daniilpass/edog/cad/custom/README.md

# STL для печати

Что печатать для текущей версии (на XIAO) и в каком количестве, сказано в [README](../../README.md#что-напечатать). Здесь описано, что представляет собой каждая деталь и как её печатать.

Оригиналы лежат в `cad/origin/` и не редактируются. Исправленный оригинальный блок привода — `cad/origin/geometry_fix/fixed_motor_bloc.stl`.
Тестовые вставки для проверки посадок — в `tests/`.

| Файл | Что это | Исходник |
|---|---|---|
| `chassis_large.stl` | большой корпус со стрелкой «перёд» на полу | `cad/freecad/EDOG_T_Front_Mark.FCStd` |
| `chassis_small.stl` | компактный корпус под площадку на магнитах (версия на RPi, для XIAO не нужен) | `cad/freecad/body_magnets.FCStd` |
| `platform_small.stl` | крышка корпуса на 4 магнитах 6×2, 113×70: в версии на XIAO на ней лежит батарея, в версии на RPi на ней стоит Raspberry Pi | `cad/freecad/body_magnets.FCStd` |
| `motor_block.stl`, `motor_block_insert.stl` | блок привода с гнездом серво 23.5 × 12.5 мм и вставка | `cad/freecad/EDOG_R_Servo_Fit.FCStd` |
| `tibia.stl`, `tibia_insert.stl` | голень с гнездом серво 23.5 × 12.5 мм и вставка. Для левых ног — как есть, для правых — зеркально (Mirror в слайсере) | `cad/freecad/Tibia_v2_SG90_fit.FCStd` |
| `femur_double_with_supports.stl` | бедро под двухсторонний лепесток, вал Ø7.1, с поддержками | `cad/freecad/Femur_hub71_double.FCStd` |
| `dc_deck.stl` | дека под UBEC 8A и DC-DC 2×USB (вариант на XIAO ESP32-S3) | `cad/freecad/EDOG_V_XIAO_Layout.FCStd` |
| `xiao_stand.stl` | подставка XIAO ESP32-S3 Sense: держит USB-C и объектив, 2 винта M3 в пол | `cad/freecad/EDOG_V_XIAO_Layout.FCStd` |
| `xiao_stand_with_supports.stl` | та же подставка XIAO с поддержками под мостом над окном штекера (стенки 0.8, зазор 0.2 сверху и снизу, 0.8 до ног) | `cad/freecad/EDOG_V_XIAO_Layout.FCStd` |
| `xiao_stand_cap.stl` | крышка подставки XIAO: над платами, язык на объектив, 2 самореза M1.7 | `cad/freecad/EDOG_V_XIAO_Layout.FCStd` |
| `pca_brackets.stl` | рамка PCA: 2 Г-полки 3 мм за платой (M3 с гайкой через нижние отверстия), 2 винта M3 в пол | `cad/freecad/EDOG_V_XIAO_Layout.FCStd` |
| `body_shell.stl` | гранёный кожух в габарите шасси (не выступает): стенка 0.8 (2 периметра), ~19.4 г, на крыше сквозная надпись EDOG (Arial Bold 20 мм, трафаретная перемычка 1.4 через все буквы, в D и O ещё вертикальная 1.4 — середины держатся в 4 точках и не проворачиваются; средняя палка E расширена симметрично, щели по 1.6) и по 4 поперечные прорези 3 мм с каждой стороны — «позвоночник», отступы до края крыши и до козырька по 3.8; стоит на стенках шасси (Z 18) и на платформе (Z 22), держится 4 магнитами 6×2 в стойках над угловыми магнитами платформы. Батарея на стяжках к платформе — кожух её не держит, рёбер нет. В середине борта юбка идёт по скосу моторной рамы на 1 мм ниже её края (заходит за раму изнутри, щели сбоку нет); у ножек платформы (углы с магнитами) юбки нет: край прямой, щель до видимой ножки ~1.2 мм со стороны торца и 2 мм со стороны центра (платформа может сдвинуться на магнитах на 1 мм и не упрётся). Спереди проём под XIAO, сверху на него клеится козырёк. Печать крышей вниз (STL уже повёрнут), без поддержек, 200×70 | `cad/freecad/EDOG_V_XIAO_Layout.FCStd` (`BodyShell`) |
| `xiao_visor.stl` | козырёк-«голова» над XIAO, ~3.6 г, ширина Y 15.5…54.4: клеится сверху на кожух — низ стенок повторяет поверхность кожуха вокруг проёма; передняя стенка над вырезом подставки доходит до торца шасси. Окно камеры по прямоугольному вырезу подставки (+0.5). На крыше два продольных паза 3 мм под вывод плоской антенны: вдоль боковых краёв крыши над боками крышки подставки (антенна выходит сбоку крышки): Y 22.9 и 47.0, X 134–161, концы скруглены, до кромки крыши ~2.7. До XIAO 0.58, до крышки подставки 0.78. Печать крышей вниз, без поддержек | `cad/freecad/EDOG_V_XIAO_Layout.FCStd` (`XiaoVisor`) |
| `gamepad_phone_holder_fold6.stl` | держатель телефона на Xbox-геймпад под сложенный Galaxy Fold 6 в Kindsuit (~71.5×16): чашки S-пружины шире на 8 мм, натяг ~5 мм; скоба на геймпад без изменений. PLA без заполнения, боком на стол | [XBox Controller Phone Holder](https://www.thingiverse.com/thing:5762576) by spiderkitty72, CC BY |

## Электроника на XIAO ESP32-S3 Sense (EDOG_V)

Сборка `EDOG_V_XIAO_Layout.FCStd` — корпус `chassis_large` без изменений, крышка 113×70 (`OriginalSizePlatform`). Модель XIAO — официальный STEP Seeed (`cad/vendor/xiao_esp32s3_sense/`).

- **LiPo 2S 2200 (110×31×14)** — на крышке по центру, провода назад; спускаются в щель между PCA и крышкой.
- **PCA9685** — в задней открытой зоне, на ребре: клеммы вниз (провода клемм — 2–3 мм под платой), верх на ~1 мм выше стенки, компоненты и разъёмы серво вперёд; тыл платы в 7 мм от задней стенки. Рамка (`pca_brackets.stl`, ~0.9 г): две вертикальные полки 3 мм вплотную за платой у нижних отверстий; винт M3 спереди через отверстие платы и полку (Ø3.6), гайка — на задней стороне полки (до ножек платы 1.2 мм, до стенки корпуса 1.4 мм; винт M3×8). Полосы 1 мм по полу под платой ведут к дальним отверстиям пола (X −5.5 × Y 11.8 и 60.8) + перемычка. Верхние отверстия PCA заняты припоем. Сборка: рамка винтами в пол (до PCA — потом винты закрыты разъёмами) → плата к полкам → M3 с гайками.
- **Дека** (`dc_deck.stl`, ~6 г) — под крышкой, скелет: две рамки-посадки, сцепленные между собой, и рычаги к трём пятакам под винты M3 (X 26.9 × Y 11.8 и 60.8, X 104.9 × Y 11.8 — отверстия пола, не закрытые платами). Винт обычный, головка сверху; в печатных деталях отверстия Ø3.6 — свободный проход, в отверстия пола (Ø3) M3 вкручивается с усилием — гайка снизу по желанию. Стенки, рельсы, основание рамок, рычаги и пятаки под винты — 1 мм.
  - UBEC 8A — рамка 52.6×36.6 с бортами 4 мм, по торцам только углы: выход (3-пин) назад к PCA, вход вперёд. Основание 1 мм: половина со стороны выхода — сплошной пол, вторая половина — кольцо 5 мм; UBEC на двустороннем скотче.
  - DC-DC 2×USB (текстолит 57×18, USB свисает за край на ~11 мм — над торцом рамки) — рамка только для положения: бока до верха текстолита, торцы на 0.6 ниже (под свесом USB), пол залит, кроме 16 мм у каждого торца, внутри рельсы под кромки платы — ножки выводов до 3.4 мм под текстолитом. Зазор 0.5 мм, плата на двустороннем скотче на рельсах. Рамка симметричная: плата ставится USB назад (как в сборке) или вперёд. Клеммник DC — общая точка: туда идут и T-plug батареи, и вход UBEC.
- **T-plug** — без своего места, прижат проводами над платами.
- **Подставка XIAO** (`xiao_stand.stl`, ~8 г + `xiao_stand_cap.stl`, ~1.2 г) — в передней открытой зоне, планка — 2 винта M3 в пол (X 137.3 × Y 11.8 и 60.8, отверстия Ø3.6).
  - XIAO стоит **USB-C вниз**, подставка держит разъём USB-C и объектив.
  - Крышка ложится сверху над платами (зазор 0.8), язык прижимает объектив, крючок заходит за плату. Крепится 2 саморезами M1.7 в стойки подставки (X 160.9 × Y 24.2 и 44.5): в стойках отверстия Ø1.5, в крышке — Ø2.
  - Радиатор 10×10×5 на тыле XIAO, между гребёнками, верх в 2 мм от края платы; на термоскотче 0.5.
  - `tests/xiao_stand_TEST_top.stl` — верх подставки для проверки посадки платы и объектива.
- **Центр масс электроники** (оценка: LiPo 120 г, UBEC 30, DC 17, PCA 14, XIAO 7, T-plug 6, дека и стойка по объёму PLA; посчитан для прежней стойки камеры) — +0.3 мм вперёд и 0.4 мм вбок от центра между осями бёдер.

**Печать.** Дека и рамка PCA — основанием на стол, без поддержек. Подставка XIAO — основанием на стол, файл `xiao_stand_with_supports.stl`: под рамкой платы на Z 17.6 висит мост над окном штекера и перемычки по бокам, под ними встроены поддержки — стенки 0.8 по контуру свеса, зазор 0.2 сверху и снизу (до подошвы), 0.8 до ног, чтобы не слиплись; вынимаются вбок. Крышка подставки — верхней гранью на стол (STL уже так повёрнут).

## Гнездо серво (motor_block, tibia)

Гнездо под корпус серво — **23.5 × 12.5 мм**. Проверено тестовыми рамками (2026-10-18), рамка с итоговым размером — `tests/motor_block_servo_fit_TEST.stl`: 23.0 × 12.5 — серво не входит, 23.5 × 13.0 и больше — люфт 0.5–1 мм.

## Бедро: отверстие под крыло MG90S

Первая доработка `cad/origin/Femur.stl` (была `Femur_hub7.stl`); на ней основано текущее бедро.

**Проблема.** Крыло серво MG90S (пластиковая насадка на вал) не входило в femur: цилиндр крыла Ø7 мм, а отверстие под него в оригинале Ø6.2 мм. Плоская часть крыла (общая длина 19 мм) входила впритык: длина паза около 19.3 мм.

**Исправление.** Отверстие под цилиндр на обоих концах (центры на расстоянии 50 мм) расширено до **Ø7.4 мм** (+0.4 мм зазора на печать) на всю глубину бобышки. Скруглённый конец паза расширился вместе с ним, длина паза стала около 19.9 мм. Стенки вокруг отверстия — около 2.3 мм. Остальная геометрия не менялась.

**Проверка.** `tests/Femur_hub7_test.stl` — тестовая вставка: вырезанное посадочное место (24 × 12 × 5.5 мм). Напечатана, крыло садится (2026-10-18). Зазор +0.4 мм к диаметру подходит для вертикальных отверстий на нашем принтере.

**Печать.**
- Класть пазами вниз: обратная сторона детали фигурная (выемки Ø21, скосы), ровно на стол она не ляжет.
- Поддержки не нужны: потолок паза — короткий мост шириной 6.2 мм, нижний край скошен под 45°.
- Поддержки слайсера лучше не включать: они встанут в пазы под крыло, и остатки помешают крылу сесть. Нужные поддержки уже есть в STL.

## femur_double_with_supports.stl

Исходник — объект `Femur_double_horn` в `cad/freecad/Femur_hub71_double.FCStd` (без поддержек; из него же берёт бедро `cad/web/export_web_models.py`).

**Проблема.** Однолучевой лепесток держался двумя шурупами с одной стороны вала. Боковая нагрузка вырывала шурупы, и бедро подгибалось внутрь. Отверстие Ø7.4 под вал давало люфт.

**Исправление.**
- Старый паз залит и вырезан заново одним симметричным профилем через вал под двухсторонний лепесток: 32.5 мм от конца до конца, глубина 2.5 мм, как раньше. Стенки без уклона, поэтому на стыке луча с ступицей нет ступенек. Шурупов по одному на луч, на дальних местах: ±13 мм от вала на конце X 0, ±12 мм на конце X −50. Отверстия Ø1.5 под саморез M1.7, сквозные. Старые Ø2 залиты: снизу от них остаётся раззенковка Ø2 глубиной 0.3–0.6 мм. Ближние отверстия (7 и 6 мм от вала) закрыты: под ними только пол 2 мм, шуруп там почти не держит, а кончик выходит к серво.
- Торцы удлинены на 5.9 мм, расстояние между осями осталось 50 мм. Стенка за концом паза 1.2 мм, высота выступа 8 мм. C-вырез заполнен там, где через него идёт луч. Выемка Ø21 под серво и пол под пазом (2 мм) не менялись.
- Отверстие под вал лепестка (Ø7) — Ø7.1 вместо Ø7.4, под полом паза (Y 2.5…4.5). В плоскости лепестка (Y 0…2.5) круг остался Ø7.4, как раньше: там лежит плоская часть лепестка.
- В STL встроены поддержки Ø4 под потолком паза на местах всех восьми бывших шурупов, включая закрытые ближние (зазор 0.2 мм). Без них навесной потолок паза печатается криво.
