daniilpass/edog/docs/hardware.md

# Железо

Список покупок, схема подключения и порядок сборки описаны в [README](../README.md#что-купить). Здесь — подробности и заметки.

## Текущая версия: XIAO ESP32-S3 Sense

| Узел | Что стоит | Заметки |
|---|---|---|
| Вычислитель | Seeed XIAO ESP32-S3 Sense (камера OV2640, 8 МБ PSRAM) | стоит USB-C вниз, камерой вперёд. Радиатор 10×10×5 на тыле |
| Серво | 8× MG90S, по 2 на ногу (бедро, колено) | паспортный максимум 0.08 с/60° при 6 В, пик тока ~0.9 А |
| Драйвер серво | PCA9685, I²C, адрес 0x40, 50 Гц | логика от 3V3 XIAO, силовая шина V+ от UBEC |
| Питание серво | UBEC 8A, выход 6 В перемычкой | прошивка ограничивает число одновременно включённых серво по току: 8 А / 0.9 А |
| Питание XIAO | DC-DC 5 В с 2×USB-A, кабель USB-A → USB-C | |
| Батарея | LiPo 2S 2200 мА·ч, T-plug | лежит на крышке, ~120 г |
| Управление | BLE-геймпад (Xbox Wireless Controller и др.) | сопряжение из портала |

Раскладка внутри корпуса описана в [cad/custom/README.md](../cad/custom/README.md#электроника-на-xiao-esp32-s3-sense-edog_v), сборка в FreeCAD — `cad/freecad/EDOG_V_XIAO_Layout.FCStd`.

### Подключение

```text
LiPo 2S (T-plug) ──► клеммник IN DC-DC 5 В ──┬── DC-DC 5 В ── USB ──► XIAO
                                             └── вход UBEC 8A (6 В) ──► V+ / GND PCA9685 ──► серво

XIAO D4 (GPIO5) ── SDA PCA9685      XIAO 3V3 ── VCC PCA9685
XIAO D5 (GPIO6) ── SCL PCA9685      XIAO GND ── GND PCA9685
```

Каналы серво (бедро / колено): FL 4/5, RL 6/7, FR 8/9, RR 10/11. Пины, адрес PCA9685 и каналы задаются в [`xiao/firmware/edog/config.h`](../xiao/firmware/edog/config.h).

### Если серво не двигаются

Портал показывает PCA9685 без ошибок, сигнал включён, а ноги стоят. Значит, нет питания на V+ PCA9685:
- проверь мультиметром 6 В на клеммнике V+/GND PCA9685;
- провода выключателя UBEC: питание есть, когда они **разомкнуты**, а если их скрутить, UBEC выключается.

## Серво и посадки

- В оригинале EDOG — SG90 или VOTIK 7455, у нас MG90S.
- Гнездо серво в раме и голени — 23.5×12.5 мм, отверстие под вал лепестка — Ø7.1–7.4. Проверено тестовыми вставками, подробности в [cad/custom/README.md](../cad/custom/README.md).

## Версия на Raspberry Pi (легаси)

Первая версия собаки. Код — `rpi/`, сервис и API описаны в [rpi/firmware/README.md](../rpi/firmware/README.md).

- Raspberry Pi 3B+ (в оригинале RPi Zero WH) на площадке с магнитами: `cad/custom/chassis_small.stl` + `cad/custom/platform_small.stl`, исходник `cad/freecad/body_magnets.FCStd`.
- PCA9685, 8× MG90S — как сейчас, но каналы серво другие (`rpi/firmware/config/config.toml`).
- Питание от сети: блок LP43 12 В / 10 А, разъём DC 5.5×2.5. Серво питает тот же UBEC 8A (5.2 или 6 В), Raspberry Pi — LM2596 5 В / 3 А.

```text
Блок питания 12 В / 10 А
        ├── UBEC 8A ── V+ PCA9685 ── серво
        └── LM2596 5 В / 3 А ── USB Raspberry Pi 3B+

Raspberry Pi ── I²C (SDA, SCL) ── PCA9685
Raspberry Pi 3,3 В ── VCC логики PCA9685
Общий GND: Raspberry Pi, PCA9685 и оба преобразователя
```

### Питание RPi: замеры

Просадку показывают `vcgencmd get_throttled` и строки «Undervoltage detected» в `journalctl -k`. Порог RPi 3B+ около 4.63 В на входе. Расшифровка битов — в скилле `.claude/skills/edog-pi`.

| Дата | Вариант питания | Нагрузка | get_throttled | Просадки | Частота ARM | Итог |
|---|---|---|---|---|---|---|
| 2026-10-18 | LM2596 5 В / 3 А → USB-выход → кабель micro-USB | простой, load 0.18, без серво и плат | `0x50005` | 6 за 4 мин | 600 МГц (троттлинг) | ❌ не хватает уже в простое |
| 2026-10-18 | то же; мультиметр: выход LM2596 5.00 В, пин 2 RPi 4.89 В | простой, load 0.05 | `0x50000` | ещё 4 за 8 мин | — | ❌ кабель + предохранитель ≈ 0.3 Ом; на пиках 1–1.2 А на плате ~4.63–4.7 В |
| 2026-10-18 | LM2596 → провода на GPIO пины 5 В / GND, минуя micro-USB | простой после загрузки, load 2.0 → 0.7 | `0x50005` во всех 30+ опросах | 1 (бит «сейчас» не снимается) | 600 МГц (троттлинг) | ❌ напряжение ниже порога постоянно, хуже, чем через USB |
| 2026-10-18 | отдельный блок питания, без LM2596 | 8 мин простоя, затем 60 с на 4 ядра | `0x0` в простое, `0x80008` под нагрузкой | 0 | 1.4 ГГц → 1.2 ГГц с 60 °C (мягкий температурный предел), пик 67.7 °C | ✅ питания хватает; ограничение только по температуре |

Вывод: сам преобразователь не проседает, но запаса не хватает. При 5.0 В на выходе до порога остаётся 0.37 В, и пики тока RPi их съедают. Нужно 5.1–5.2 В на выходе и/или короткий толстый провод до пинов 2/4 и 6, минуя micro-USB. Это одна из причин перехода на XIAO.

## В планах

- 4 колеса на лапах (все ведущие) — альтернативный режим передвижения
- микрофон XIAO в портале
