daniilpass/edog/docs/project.md

# О проекте

Edog — квадропод на 3D-печати. Основа — открытый проект, который автор сейчас забросил.

## Источники (оригинал)
- Hackaday: https://hackaday.io/project/177204-edog-mini-3d-printed-quadruped-robot
- Инструкция (Part 1): https://medium.com/@solidmakers/build-your-own-quadruped-robot-with-edog-part-1-e5e2f3a08729

## Чем наша версия отличается от оригинала
- Вычислитель: в оригинале Raspberry Pi Zero WH, у нас сначала был Raspberry Pi 3B+ (легаси, `rpi/`), сейчас Seeed XIAO ESP32-S3 Sense с камерой (`xiao/`).
- Питание: LiPo 2S на крышке, UBEC 8A на серво, DC-DC 5 В на плату.
- Корпус: большой `chassis_large` со стрелкой «перёд», крышка на магнитах, деки под электронику, подставка XIAO, кожух с надписью EDOG и козырёк над камерой. Компактный корпус под RPi — `chassis_small` + `platform_small`.
- Исправлена геометрия блока привода (motor bloc): `cad/origin/geometry_fix/fixed_motor_bloc.stl`. Моторные рамы и голени переделаны под гнездо серво 23.5×12.5.
- Бедро: место под лепесток расширено под MG90S, затем бедро переделано под двухсторонний лепесток (`cad/custom/femur_double_with_supports.stl`). Подробности — [cad/custom/README.md](../cad/custom/README.md).
- Серво: в оригинале SG90/VOTIK 7455, у нас MG90S.
- Программа своя: рысь с профилями шага, калибровка из портала, BLE-геймпад, веб-портал с 3D-моделью, видео с камеры, патруль с распознаванием людей, сон, прошивка по воздуху, приложение для Android.

## Текущий прототип

- Четыре ноги, по два MG90S на ногу: всего 8 приводов. Колено смотрит назад.
- Серво управляет PCA9685 по I²C. Обратной связи по положению суставов нет: углы задаются по калибровке.
- Камера XIAO: люди (ESP-DL), граница свободного пола, карта вокруг собаки — [patrol.md](patrol.md).

Подробности по железу — [hardware.md](hardware.md).

## Планы развития
- Альтернативный ходовой режим: 4 колеса на лапах, все ведущие
- Микрофон XIAO в портале
