daniilpass/edog/docs/patrol.md

# Патруль по камере

Собака сама, без ПК и портала:
1. ходит по дому и старается уходить в новые места;
2. находит человека, подходит и приветствует его;
3. идёт дальше до следующей встречи.

Всё работает на XIAO ESP32-S3 Sense. Портал и приложение на Android нужны только посмотреть, что видит собака: видео с разметкой и радар.

Код: [`vision.cpp`](../xiao/firmware/edog/vision.cpp) — зрение, [`patrol.cpp`](../xiao/firmware/edog/patrol.cpp) — патруль, [`pedestrian.cpp`](../xiao/firmware/edog/pedestrian.cpp) — детектор людей. Параметры — в разделах «зрение» и «патруль» файла [`config.h`](../xiao/firmware/edog/config.h).

## Запуск и остановка

| Что | Как |
|---|---|
| Включить | кнопка «Запустить патруль» в портале или в приложении, крестовина → на геймпаде |
| Выключить | крестовина → ещё раз, кнопка в портале или приложении, СТОП, выключение серво |
| Ручное управление | стик, любая кнопка геймпада или команда движения из портала выключают патруль. Снова — только кнопкой |

Сам патруль не включается. После включения питания собака только встаёт в базовую стойку; после прошивки по воздуху, сбоя или просадки питания — не встаёт: её могли оставить на столе.

## Зрение: связка инструментов

Модели, которая на ESP32-S3 видит и людей, и препятствия, и расстояния, нет. Поэтому работает несколько простых инструментов, и их результаты сходятся в одну картину.

| Инструмент | Что даёт |
|---|---|
| **Геометрия пола** | высота и наклон камеры → строка кадра переводится в расстояние по полу. Калибруется в портале по точкам |
| **Люди** — нейросеть ESP-DL `pedestrian_detect` (Pico, 224×224, int8) | рамка, уверенность; расстояние — по ступням на полу, если их не видно — по высоте рамки (рост 1,65 м) |
| **Пол** | цвет и текстура у лап; по 16 полосам — до первого «не пола» → свободное расстояние |
| **Закрытость кадра** 0…1 | пол внизу пропал, кадр однотонный, центр растёт → «почти упёрлась». Разброс яркости по кадру меньше 9 (объектив вплотную к стене) → закрыт полностью, модель пола на таком кадре не учится |
| **Выравнивание соседних кадров** | остаточная разница (упёрлась), сдвиг при развороте (уточняет скорость поворота), расширение центра (приближаемся) |

Ограничения:
- **Точность расстояний** — ±20–30 % до ~2 м, дальше только «далеко».
- **Однотонный пол и контрастная мебель** — разметка пола работает хорошо. На пёстром ковре или когда пол того же цвета, что стена, она ошибается; тогда остаются закрытость и проверка «упёрлась».
- **Портреты и фото на стенах** детектор тоже принимает за людей.
- **Скорость.** Распаковка кадра ~77 мс, нейросеть ~200–260 мс, анализ пола ~60 мс: 2–3 анализа в секунду стоя. На ходу анализируются только кадры в выбранной фазе шага (~1,5 в секунду).

### Кадры в одной фазе шага

На ходу корпус качается, и кадры, снятые в разные моменты шага, отличаются сильнее, чем от самого движения. Поэтому на ходу для анализа берутся только кадры, снятые в одной и той же фазе цикла рыси:
- фаза кадра считается по отметке времени съёмки, из истории контура (100 Гц);
- кадр дальше ±5 % цикла (~30 мс) от выбранной фазы не берётся; из кадров одного окна — ближайший;
- первый цикл ходьбы пропускается: шаг ещё разгоняется.

Остаток разницы между кадрами принимается как данность:
- перед сравнением кадры выравниваются по общему сдвигу;
- всё считается на уменьшенных картинках;
- решения принимаются по нескольким кадрам: человек — на 2 из 3 анализов, стоп по закрытости — на двух подряд (или сразу, если больше 0,9);
- «упёрлась» — разница меньше 0,4 от обычной на ходу, три раза подряд.

**Подбор фазы** — кнопка в портале. 20 с собака должна идти вперёд. Кадры раскладываются по 16 фазам и сравниваются с той же фазой на прошлом цикле. Выбирается фаза, где кадры отличаются меньше всего, и сохраняется на плате. Постоянная задержка камеры при этом учитывается сама: время и выбор считаются по одним и тем же отметкам.

Стоя кадр берётся через 0,3 с после остановки.

## Патруль: как ищет новые места

Карты квартиры нет (нет IMU и одометрии), поэтому работает схема дешёвых роботов-пылесосов плюс зрительная память:

```
ПАТРУЛЬ   отрезок вперёд 2–6 с; медленнее, когда впереди близко или кадр «закрывается»
ОСМОТР    повороты по 45°: сектор ±90°, полный круг каждый 3-й раз или если тесно
          → направление = свободно × ново × немного случайности; назад — со штрафом
ПОДХОД    довернуть к человеку, дойти до ~1,1 м; пропал на 4 с — осмотр; не дошла за 20 с — дальше, 18 с людей не замечать
ПРИВЕТ    радость (joy)
ОТХОД     развернуться на 120–180°, 18 с людей не замечать → ПАТРУЛЬ
```

- **Почти упёрлась** (закрытость > 0,7 два раза подряд, или свободно < 25 см) → осмотр.
- **Упёрлась** (кадр не меняется) → назад 1,2 с → разворот 90–150° → осмотр.
- **Зрительная память** — до 100 миниатюр 16×12. Новизна вида — насколько он не похож на виденное за 8 минут. Потом место забывается, и туда можно вернуться.
- **Память пройденного.** Положение считается по курсу и шагам (плывёт, но для выбора направления хватает). Пол разбит на клетки 0,5 м, в клетке — сколько секунд собака в ней провела. При осмотре бонус направлениям в непройденные клетки и прочь от середины исхоженного, небольшой бонус — туда же, куда шла. Без этого в полутьме все виды похожи, и собака кружит у старта.
- **Вдоль стены.** Раз в 4 осмотра собака 15–20 с идёт вдоль стены: слегка забирает вправо, упёрлась — поворот влево. Так она выходит из комнаты.
- **Повороты по времени.** Скорость разворота уточняется по сдвигу картинки между кадрами.

## Радар

Локальная карта вокруг собаки — 16 секторов по 22,5°. В каждом — ближайшее препятствие и когда его видели.
- Собака поворачивается — карта поворачивается.
- Идёт — точки сдвигаются назад.
- Через 90 с сектор забывается.

Как читать радар (вид сверху, нос вверх):
- **длина клина** — свободно до препятствия;
- **бледнее** — давно видели;
- **штриховка и «?»** — не знаем;
- **◆** — человек;
- **пунктир** — что видит камера;
- **стрелка** — куда идёт.

Под радаром то же текстом.

## Калибровка (портал → «Зрение»)

1. **Пол.** Поставьте предмет на известном расстоянии от камеры (например, 500 мм), введите расстояние, нажмите «Указать на видео» и кликните по низу предмета, где он касается пола. 2–3 точки на разных расстояниях дают и высоту, и наклон камеры. Слепая зона (ближе — пол не виден) показана в карточке.
2. **Фаза.** «Подобрать фазу» и 20 с ходьбы вперёд.

Обе калибровки сразу сохраняются на плате (NVS «vision»), кнопка «Сохранить» для них не нужна.

## Что видно в портале и приложении

У каждого кадра MJPEG есть свои заголовки (их читают и портал, и приложение):

```
X-Detect: x1,y1,x2,y2,уверенность %,расстояние см;…       люди, рамки в кадре 640×480
X-Free:   16 чисел, см (−1 — неизвестно, 300 — далеко)      свободно по полосам слева направо
X-Vision: seq=…;close=0.42;synced=1;age=мс;h=мм;tilt=°;fov=°
X-Patrol: state=walk;greet=3;heading=°
X-Map:    f=°;t=°;d=16 секторов см;a=16 давность с;p=°:см,…  карта вокруг собаки
```

Портал рисует поверх видео рамки людей с подписью, пунктир свободного пола с расстояниями и строку состояния; рядом радар. Приложение на Android показывает то же: в портретной ориентации радар под видео, в альбомной — справа.

## API

- `POST /api/patrol` `{"action": "start" | "stop"}`
- `POST /api/vision/phase_scan` `{"seconds": 20}`
- `POST /api/vision/floor_point` `{"y": строка 0…479, "mm": расстояние}`, `POST /api/vision/floor_reset`
- `PATCH /api/vision` `{"phase", "phase_both", "height_mm", "tilt_deg"}`
- `POST /api/vision/detect` — тело JPEG 640×480, ответ — рамки людей. Проверка детектора без человека перед камерой.
- В состоянии — `patrol` (состояние, карта, счётчики) и `vision` (время анализа, температура, память, фаза, пол, последний анализ).

## Возможные улучшения

- **Датчики.** ToF VL53L5CX (карта глубины 8×8) и BNO085 (курс) — на ту же шину I²C. Они встанут в ту же карту, алгоритм переделывать не надо.
- **Пороги** (закрытость, «упёрлась», скорость шага у препятствий) настраиваются на собаке: значения в `patrol.cpp` и `vision.cpp` — стартовые.
