daniilpass/edog/cad/freecad/EDOG_W_Full_Assembly.FCStd

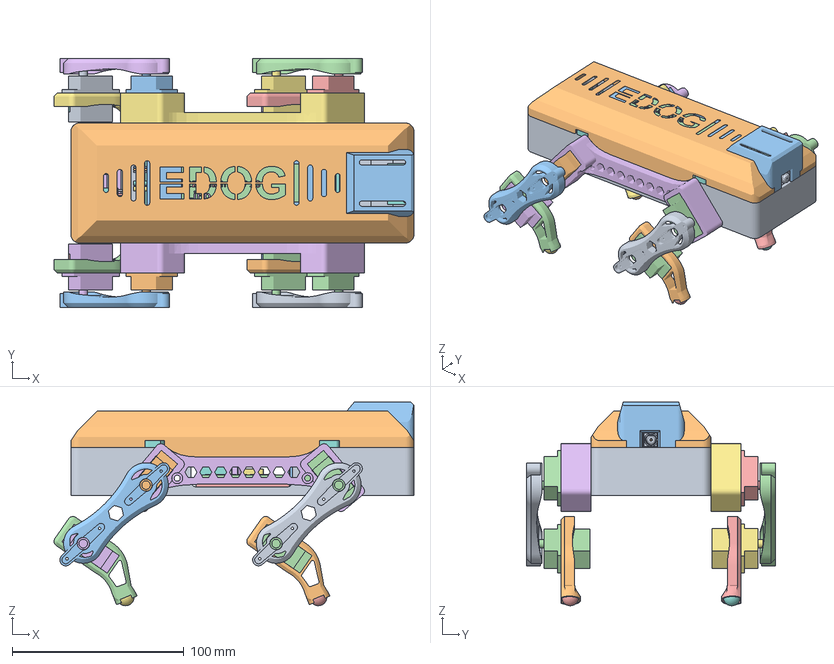
[picture p5: CAD file, 2026-10-26]
cad/freecad/EDOG_W_Full_Assembly.FCStd
209.8 x 144.9 x 118.7 mm
Chassis — пол 3 мм, открытые борта, вводы проводов; стрелка «перёд» 0.6 мм на полу
MG90S (вал к краю рамы развёрнут) — наружу на 7 мм, LeftFront
MG90S (вал к краю рамы развёрнут) — наружу на 7 мм, LeftRear
MG90S (вал к краю рамы развёрнут) — наружу на 7 мм, RightFront
MG90S (вал к краю рамы развёрнут) — наружу на 7 мм, RightRear
Моторная рама — карман 23.5×12.5, вставка снизу 1
Моторная рама — карман 23.5×12.5, вставка снизу 2
Исходная магнитная крышка — 113.36×70×4 мм, примерка
Вставка снизу 0-0
Вставка снизу 1-0
Вставка снизу 0-1
Вставка снизу 1-1
Дека — рамки UBEC и DC на рычагах, 3 винта M3 в пол (печать)
Рамка PCA — полки 3 мм за платой, M3 с гайкой сзади, 2 винта M3 в пол (печать)
Радиатор XIAO 10×10×5 — тыл платы между гребёнками, верх в 2 мм от края, термоскотч 0.5
Крышка XIAO — над платами (+0.8), язык на объектив, крючок за платой, 2 самореза M1.7 в стойки (печать)
Подставка XIAO — планка, держит USB-C и объектив, 2 винта M3 в пол (печать)
Кожух — гранёный, стенка 0.8, надпись EDOG (трафарет, D и O на 4 перемычках) + «позвоночник», юбка по скосу рамы, проём под XIAO, 4 магнита 6×2 (печать)
Козырёк XIAO — Y 15.5…54.4, клеится на кожух, низ стенок по поверхности кожуха, окно камеры по вырезу подставки, 2 паза 3 мм под антенну (печать)
BOSS-EXTRUDE14_8_
BOSS-EXTRUDE7_4_
BOSS-EXTRUDE7_3_
BOSS-EXTRUDE14_4_
BOSS-EXTRUDE14_2_
BOSS-EXTRUDE14_11_
BOSS-EXTRUDE7_7_
BOSS-EXTRUDE14_9_
BOSS-EXTRUDE14_3_
BOSS-EXTRUDE14_7_
MIRROR2
BOSS-EXTRUDE14_5_
BOSS-EXTRUDE14_12_
BOSS-EXTRUDE7_8_
BOSS-EXTRUDE7_1_
BOSS-EXTRUDE14_10_
BOSS-EXTRUDE7_9_
BOSS-EXTRUDE14_6_
BOSS-EXTRUDE14_1_
BOSS-EXTRUDE7_6_
BOSS-EXTRUDE7_2_
CUT-EXTRUDE5
BOSS-EXTRUDE7_5_
Shield
Pins
Pins001
Pins002
Pins003
Pins005
Pins006
Pins007
Pins008
U.FL-R-SMT-1_10_ v1
DF40C-30DP-0.4V_51_ v1
DF40HC(3.0)-30DS
DF40HC(3.0)-30DS001
DF40HC(3.0)-30DS002
DF40HC(3.0)-30DS003
DF40HC(3.0)-30DS004
DF40HC(3.0)-30DS005
DF40HC(3.0)-30DS006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
