daniilpass/edog/cad/custom/tests/xiao_stand_TEST_top.stl

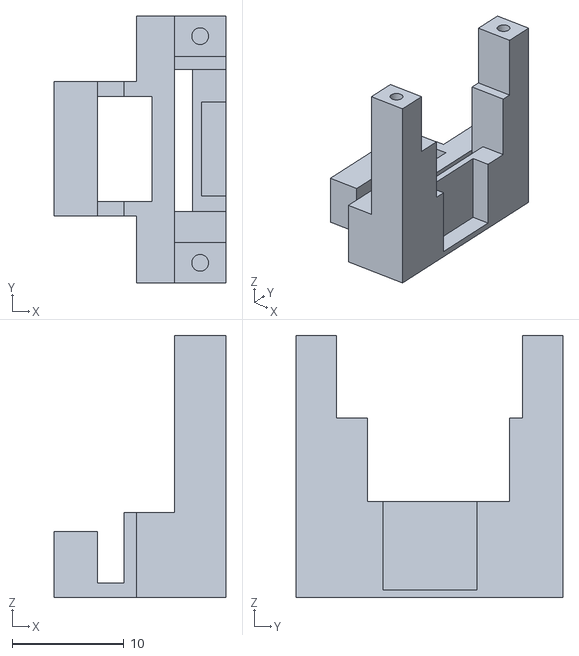
[picture p6: CAD file, 2026-10-24]
cad/custom/tests/xiao_stand_TEST_top.stl
15.3 x 23.9 x 23.4
