daniilpass/edog/cad/custom/xiao_visor.stl

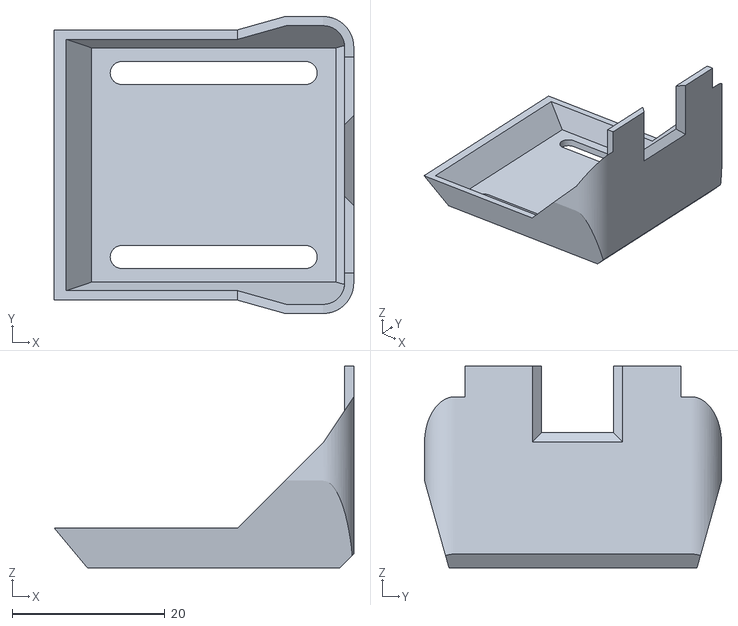
[picture p7: CAD file, 2026-10-25]
cad/custom/xiao_visor.stl
39.2 x 38.9 x 26.4
