daniilpass/edog/cad/origin/chassis.stl

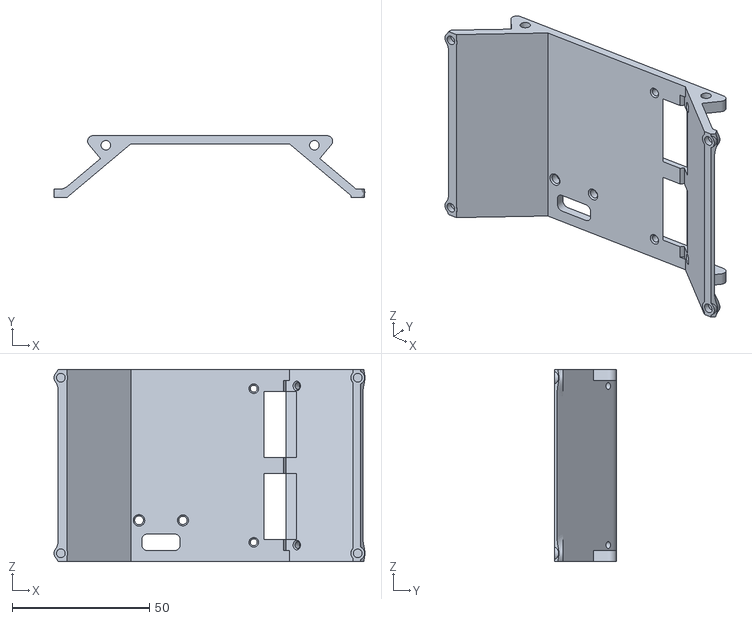
[picture p8: CAD file, 2026-10-15]
cad/origin/chassis.stl
113.4 x 22.5 x 70.0
