daniilpass/edog/cad/origin/geometry_fix/fixed_motor_bloc.stl

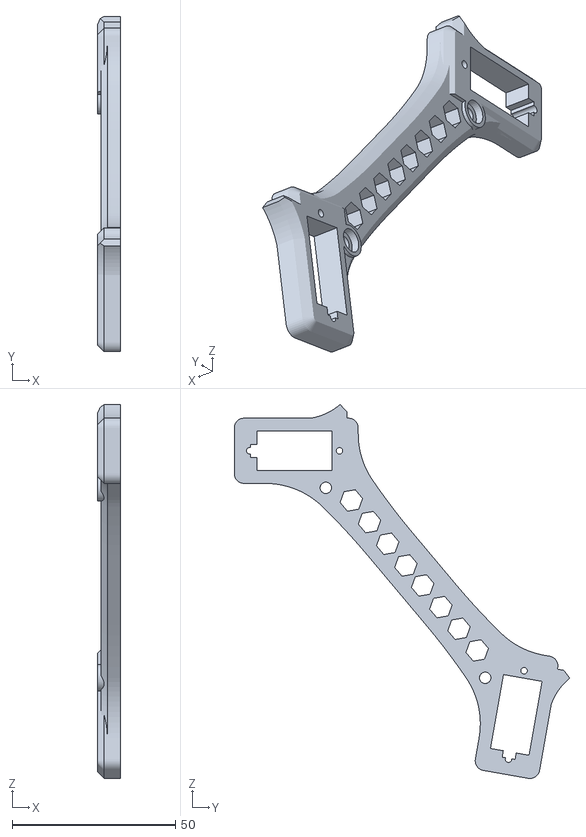
[picture p9: CAD file, 2026-10-15]
cad/origin/geometry_fix/fixed_motor_bloc.stl
7.00 x 102.8 x 114.6
