daniilpass/edog/cad/web/femur_FL.stl

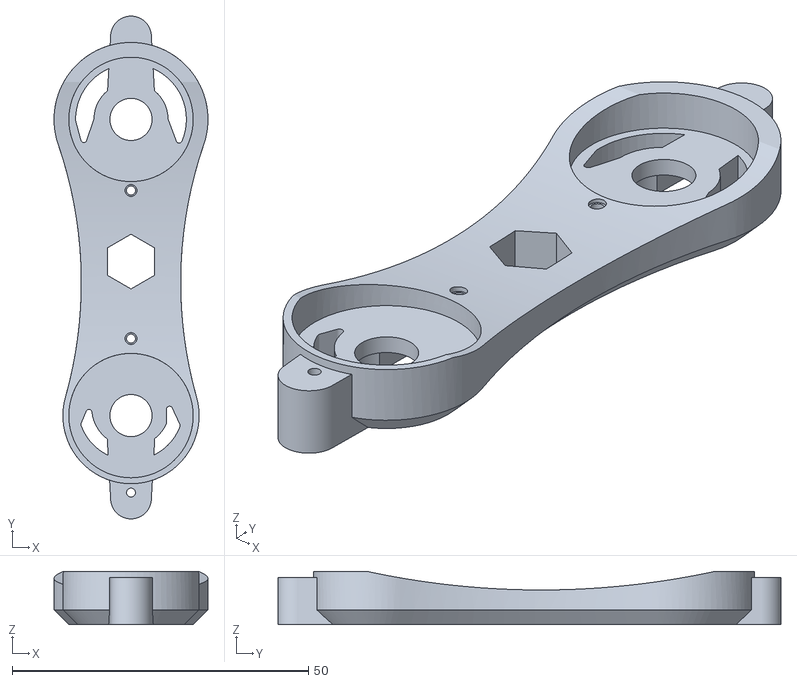
[picture p10: CAD file, 2026-10-24]
cad/web/femur_FL.stl
26.0 x 84.9 x 9.00
