daniilpass/edog/cad/custom/body_shell.stl

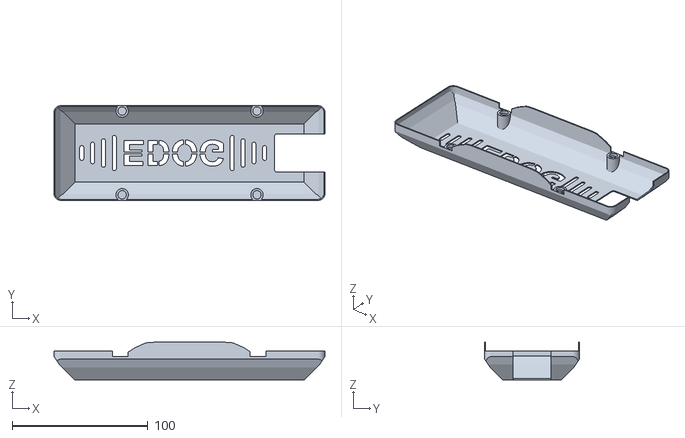
[picture p11: CAD file, 2026-10-25]
cad/custom/body_shell.stl
200.0 x 69.9 x 27.7
