daniilpass/edog/cad/custom/tests/motor_block_servo_fit_TEST.stl

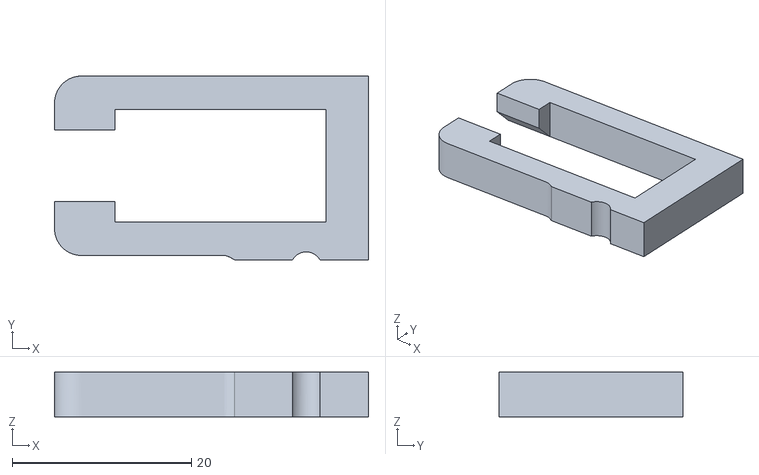
[picture p12: CAD file, 2026-10-18]
cad/custom/tests/motor_block_servo_fit_TEST.stl
35.0 x 20.5 x 5.01
