daniilpass/edog/cad/freecad/EDOG_V_XIAO_Layout.FCStd

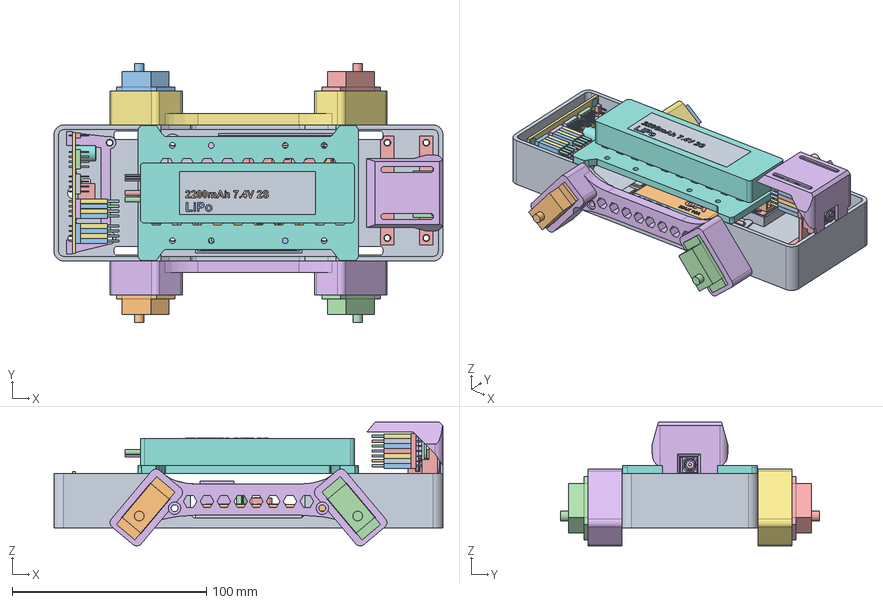
[picture p13: CAD file, 2026-10-25]
cad/freecad/EDOG_V_XIAO_Layout.FCStd
200.0 x 132.9 x 63.7 mm
Chassis — пол 3 мм, открытые борта, вводы проводов; стрелка «перёд» 0.6 мм на полу
MG90S (вал к краю рамы развёрнут) — наружу на 7 мм, LeftFront
MG90S (вал к краю рамы развёрнут) — наружу на 7 мм, LeftRear
MG90S (вал к краю рамы развёрнут) — наружу на 7 мм, RightFront
MG90S (вал к краю рамы развёрнут) — наружу на 7 мм, RightRear
Моторная рама — карман 23.5×12.5, вставка снизу 1
Моторная рама — карман 23.5×12.5, вставка снизу 2
Исходная магнитная крышка — 113.36×70×4 мм, примерка
BOSS-EXTRUDE14_8_
BOSS-EXTRUDE7_4_
BOSS-EXTRUDE7_3_
BOSS-EXTRUDE14_4_
BOSS-EXTRUDE14_2_
BOSS-EXTRUDE14_11_
BOSS-EXTRUDE7_7_
BOSS-EXTRUDE14_9_
BOSS-EXTRUDE14_3_
BOSS-EXTRUDE14_7_
MIRROR2
BOSS-EXTRUDE14_5_
BOSS-EXTRUDE14_12_
BOSS-EXTRUDE7_8_
BOSS-EXTRUDE7_1_
BOSS-EXTRUDE14_10_
BOSS-EXTRUDE7_9_
BOSS-EXTRUDE14_6_
BOSS-EXTRUDE14_1_
BOSS-EXTRUDE7_6_
BOSS-EXTRUDE7_2_
CUT-EXTRUDE5
BOSS-EXTRUDE7_5_
Shield
Pins
Pins001
Pins002
Pins003
Pins005
Pins006
Pins007
Pins008
U.FL-R-SMT-1_10_ v1
DF40C-30DP-0.4V_51_ v1
DF40HC(3.0)-30DS
DF40HC(3.0)-30DS001
DF40HC(3.0)-30DS002
DF40HC(3.0)-30DS003
DF40HC(3.0)-30DS004
DF40HC(3.0)-30DS005
DF40HC(3.0)-30DS006
DF40HC(3.0)-30DS007
DF40HC(3.0)-30DS008
DF40HC(3.0)-30DS009
DF40HC(3.0)-30DS010
DF40HC(3.0)-30DS011
DF40HC(3.0)-30DS012
DF40HC(3.0)-30DS013
DF40HC(3.0)-30DS014
DF40HC(3.0)-30DS015
DF40HC(3.0)-30DS016
DF40HC(3.0)-30DS017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
