daniilpass/edog/cad/origin/Femur.stl

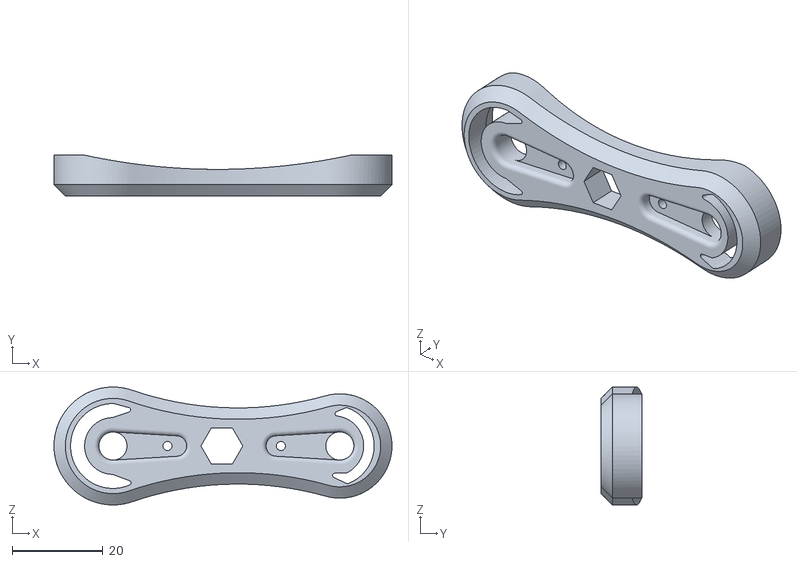
[picture p14: CAD file, 2026-10-15]
cad/origin/Femur.stl
74.5 x 9.00 x 26.0
