daniilpass/edog/cad/custom/gamepad_phone_holder_fold6.stl

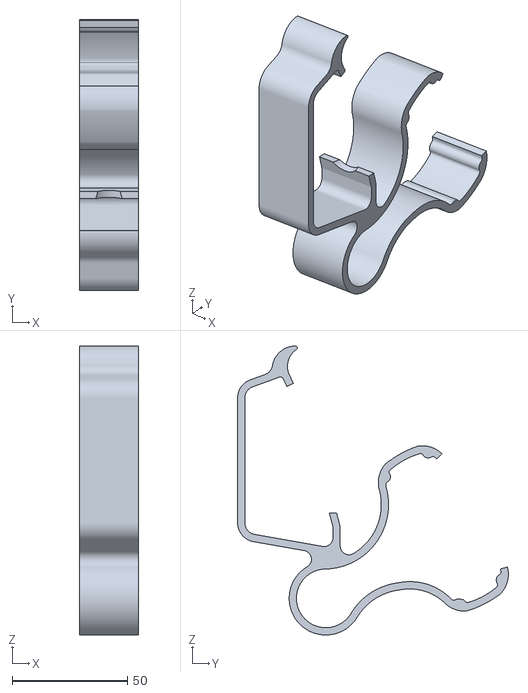
[picture p15: CAD file, 2026-10-24]
cad/custom/gamepad_phone_holder_fold6.stl
25.4 x 117.3 x 125.2
