daniilpass/edog/cad/custom/tests/Femur_hub7_test.stl

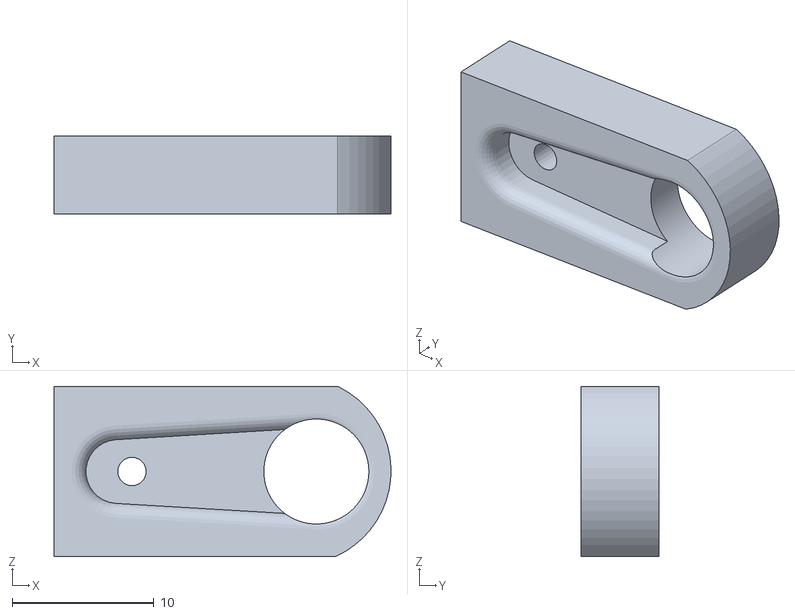
[picture p16: CAD file, 2026-10-18]
cad/custom/tests/Femur_hub7_test.stl
23.8 x 5.50 x 12.0
