daniilpass/edog/cad/origin/Tibia_v2__-_SG90.stl

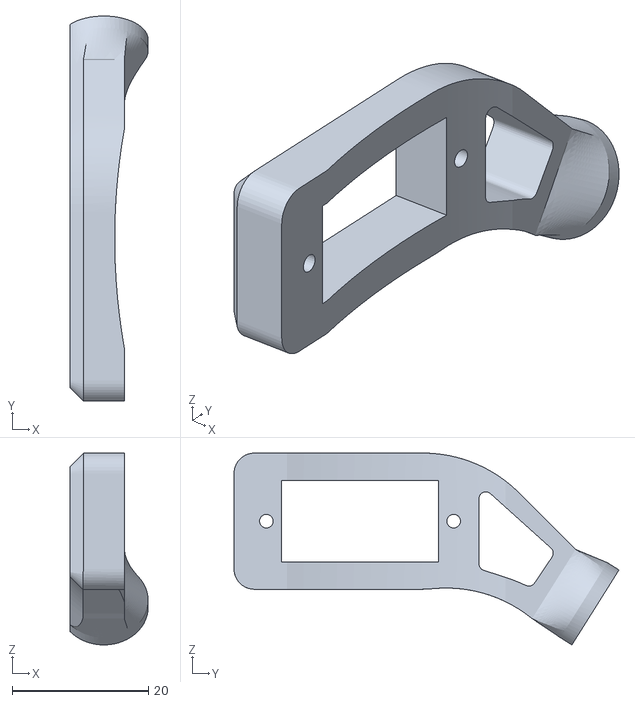
[picture p17: CAD file, 2026-10-15]
cad/origin/Tibia_v2__-_SG90.stl
11.5 x 56.5 x 28.2
