daniilpass/edog/cad/custom/xiao_stand.stl

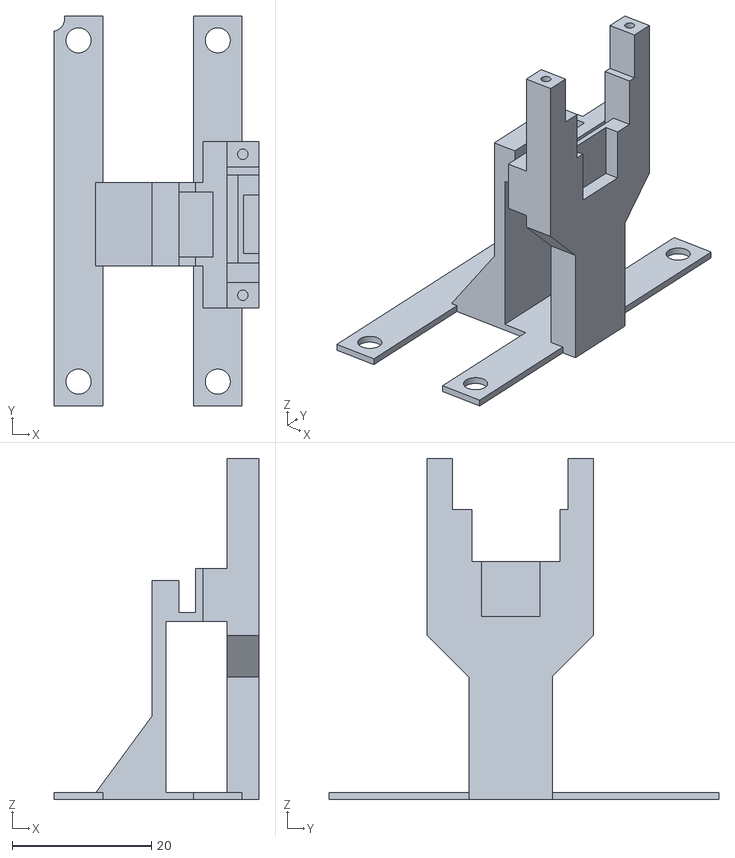
[picture p18: CAD file, 2026-10-24]
cad/custom/xiao_stand.stl
29.4 x 56.0 x 49.0
