daniilpass/edog/cad/freecad/EDOG_R_Servo_Fit.FCStd

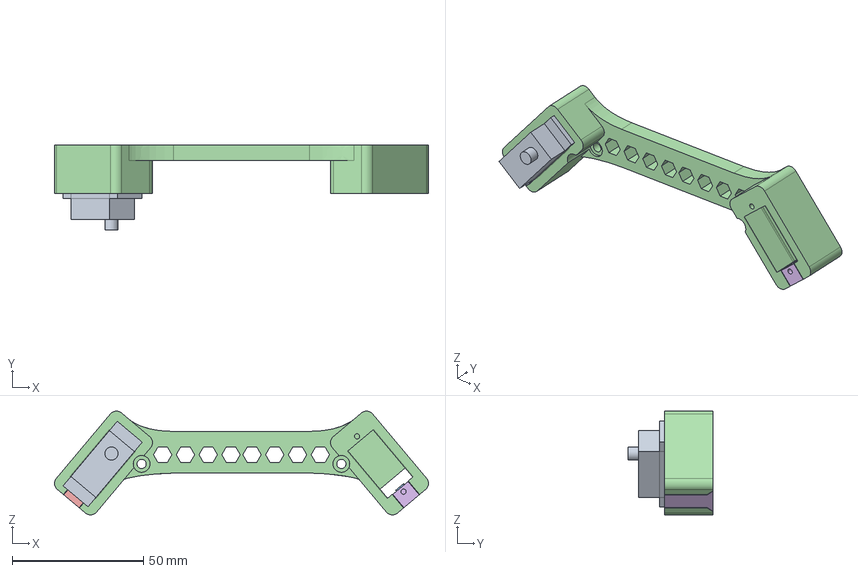
[picture p19: CAD file, 2026-10-19]
cad/freecad/EDOG_R_Servo_Fit.FCStd
142.3 x 32.5 x 39.5 mm
MG90S — наружу на 7 мм, LeftFront
Cable_LeftFront
Cable_RightFront
Моторная рама — карман 23.5×12.5, дно 1 мм (короткое), вставка сбоку 1
Вставка сбоку 0-0
Вставка сбоку 0-1
