daniilpass/edog/cad/origin/Simple_Tibia_-_VOTIK_7455.stl

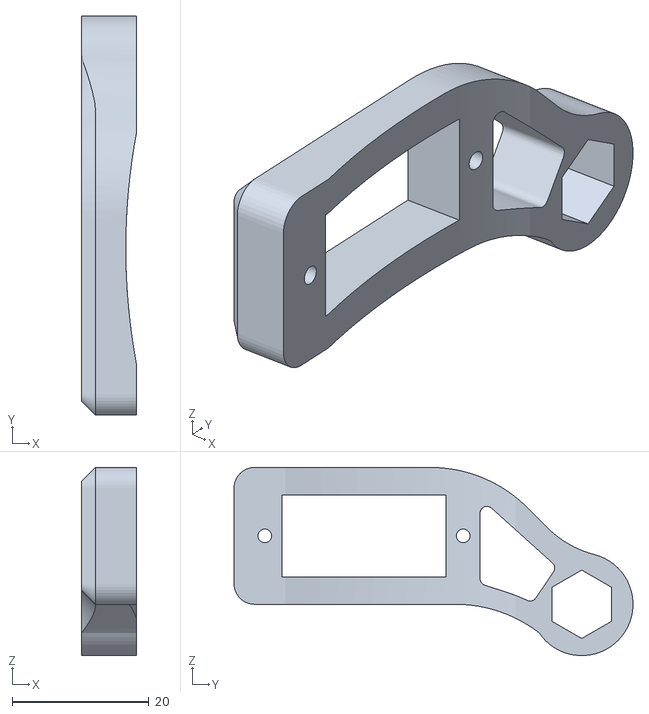
[picture p20: CAD file, 2026-10-15]
cad/origin/Simple_Tibia_-_VOTIK_7455.stl
8.00 x 58.3 x 27.5
