daniilpass/edog/cad/custom/xiao_stand_with_supports.stl

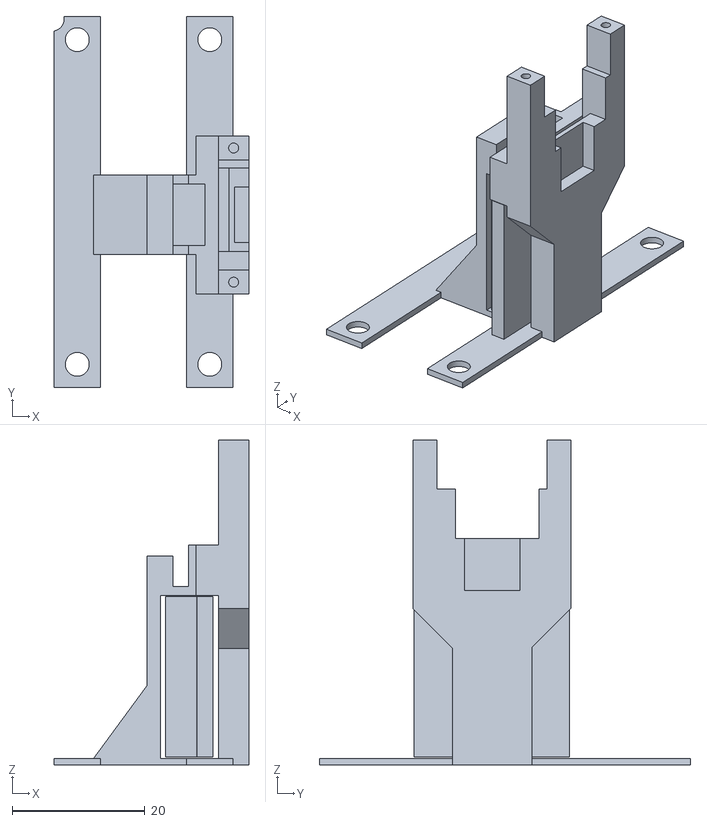
[picture p21: CAD file, 2026-10-24]
cad/custom/xiao_stand_with_supports.stl
29.4 x 56.0 x 49.0
