daniilpass/edog/cad/freecad/EDOG_T_Front_Mark.FCStd

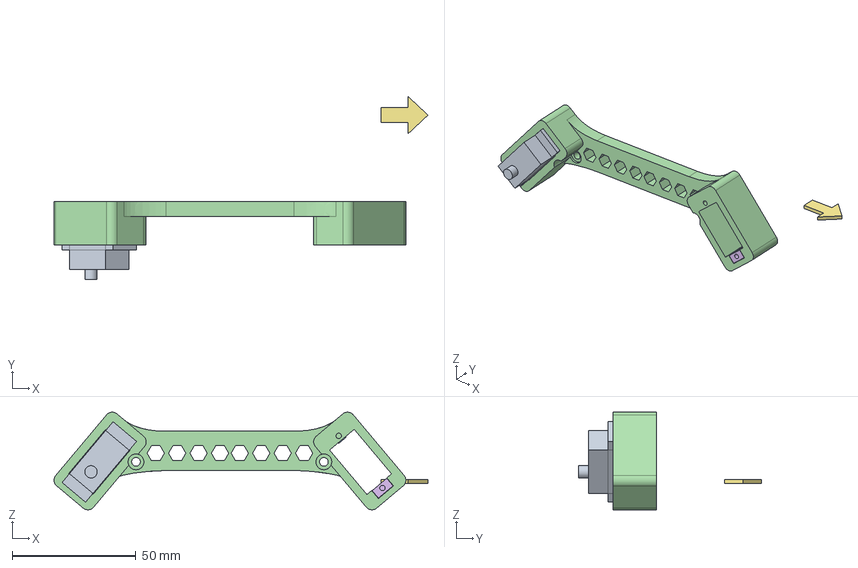
[picture p22: CAD file, 2026-10-18]
cad/freecad/EDOG_T_Front_Mark.FCStd
151.3 x 74.0 x 39.5 mm
MG90S (вал к краю рамы развёрнут) — наружу на 7 мм, LeftFront
Cable_LeftFront
Cable_RightFront
Моторная рама — карман 23.5×12.5, вставка снизу 1
Вставка снизу 0-0
Вставка снизу 0-1
Инструмент гравировки стрелки (+X, перёд)
