daniilpass/edog/cad/origin/Motor_Bloc_-_VOTIK_7455.stl

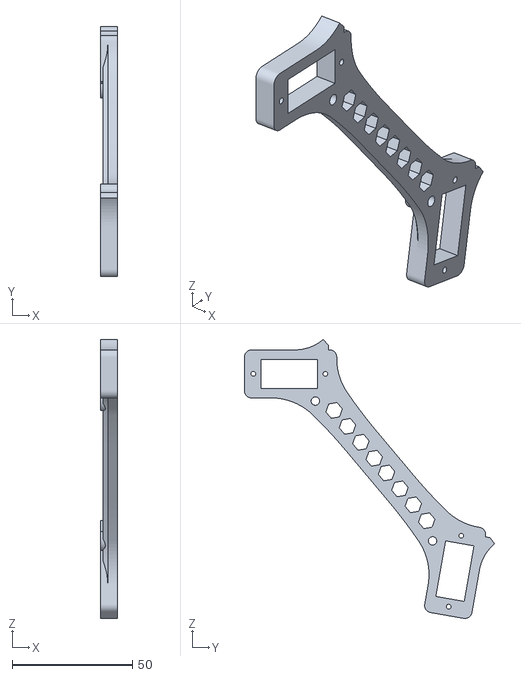
[picture p23: CAD file, 2026-10-15]
cad/origin/Motor_Bloc_-_VOTIK_7455.stl
7.00 x 104.3 x 116.2
