daniilpass/edog/cad/web/foot_pad_RL.stl

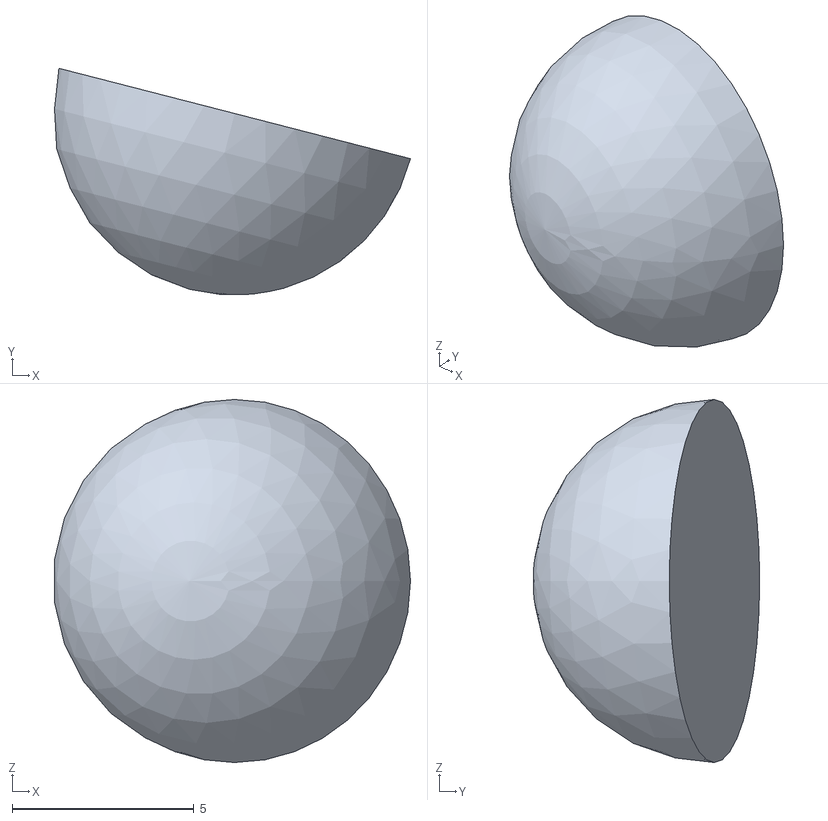
[picture p24: CAD file, 2026-10-19]
cad/web/foot_pad_RL.stl
9.81 x 6.24 x 10.0
