daniilpass/edog/cad/custom/xiao_stand_cap.stl

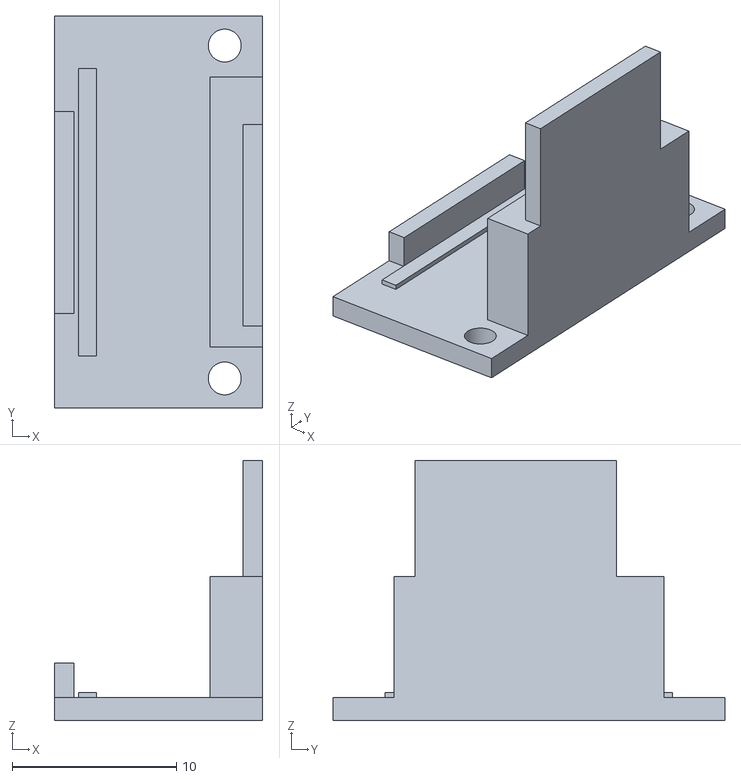
[picture p25: CAD file, 2026-10-24]
cad/custom/xiao_stand_cap.stl
12.7 x 23.9 x 15.8
