daniilpass/edog/cad/freecad/Tibia_v2_SG90_fit.FCStd

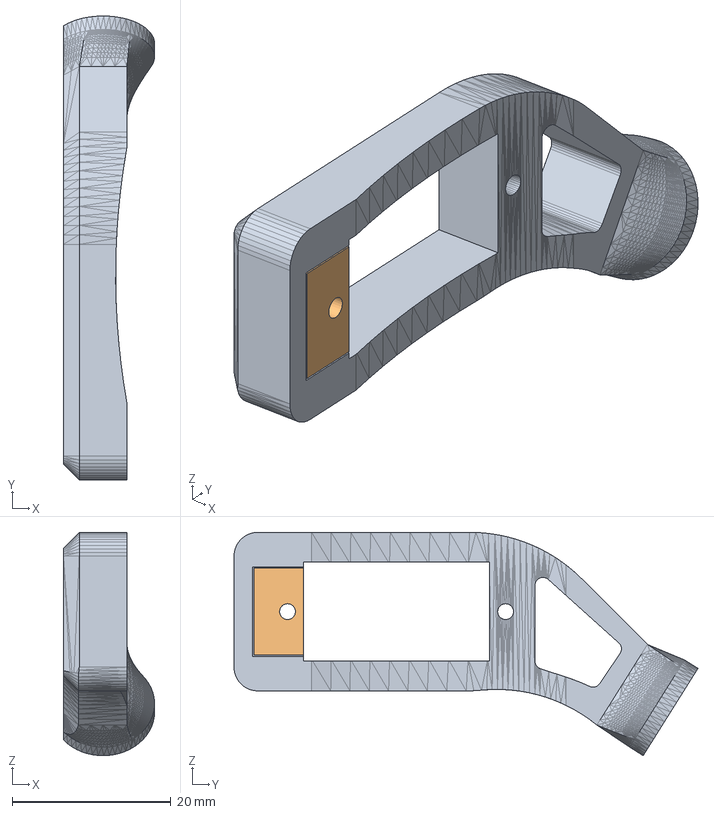
[picture p26: CAD file, 2026-10-18]
cad/freecad/Tibia_v2_SG90_fit.FCStd
11.5 x 58.5 x 28.2 mm
TibiaFit
Insert
