daniilpass/edog/cad/custom/pca_brackets.stl

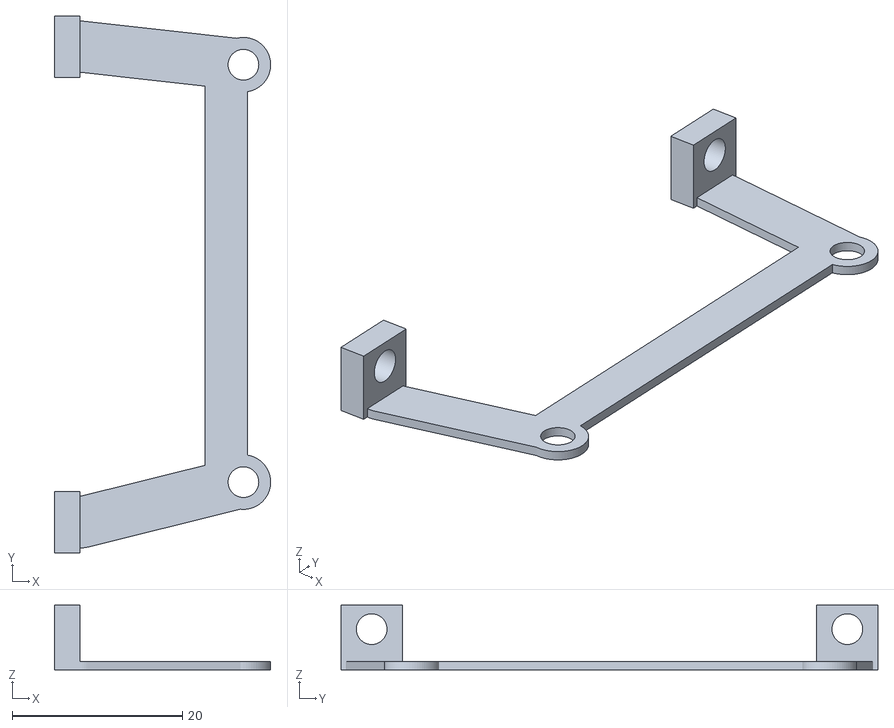
[picture p27: CAD file, 2026-10-24]
cad/custom/pca_brackets.stl
25.4 x 63.0 x 7.60
