daniilpass/edog/cad/freecad/body_magnets.FCStd

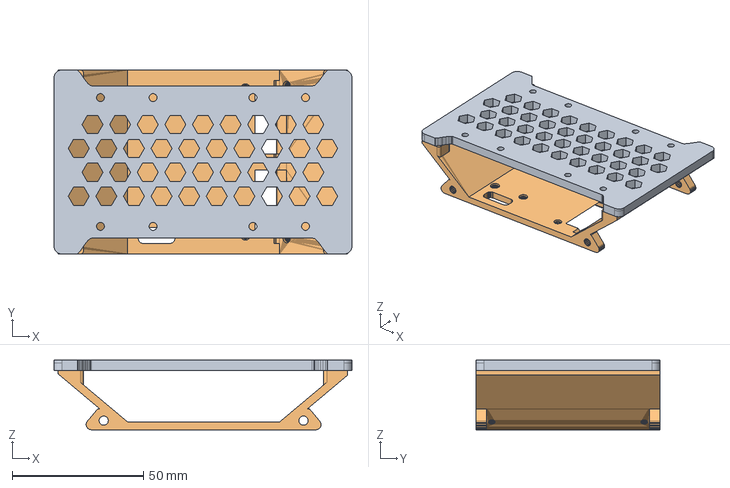
[picture p28: CAD file, 2026-10-15]
cad/freecad/body_magnets.FCStd
113.4 x 70.0 x 26.5 mm
Платформа — 4 гнезда магнитов Ø6,2 × 2,2
chassis — магниты, наклонный низ площадок
