daniilpass/edog/cad/origin/Simple_Tibia_-_SG90.stl

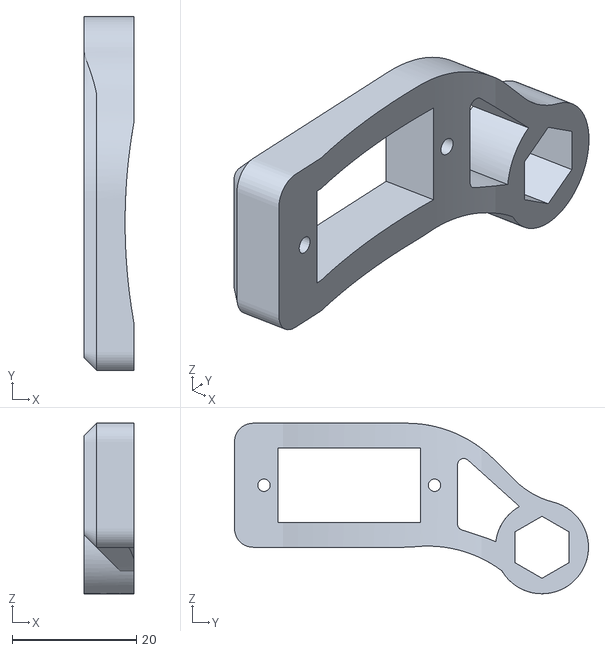
[picture p29: CAD file, 2026-10-15]
cad/origin/Simple_Tibia_-_SG90.stl
8.00 x 57.1 x 27.5
