daniilpass/edog/cad/custom/dc_deck.stl

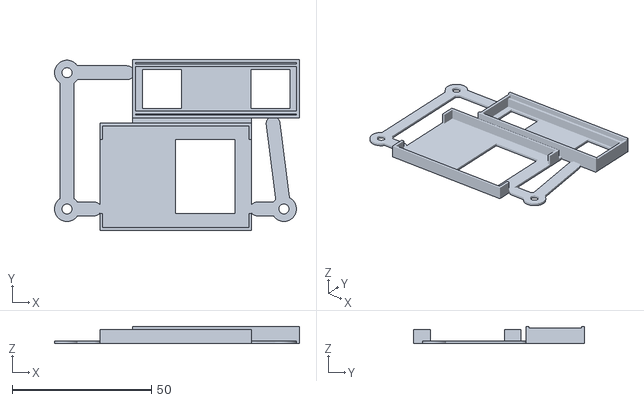
[picture p30: CAD file, 2026-10-24]
cad/custom/dc_deck.stl
88.1 x 61.4 x 6.20
