daniilpass/edog/cad/custom/femur_double_with_supports.stl

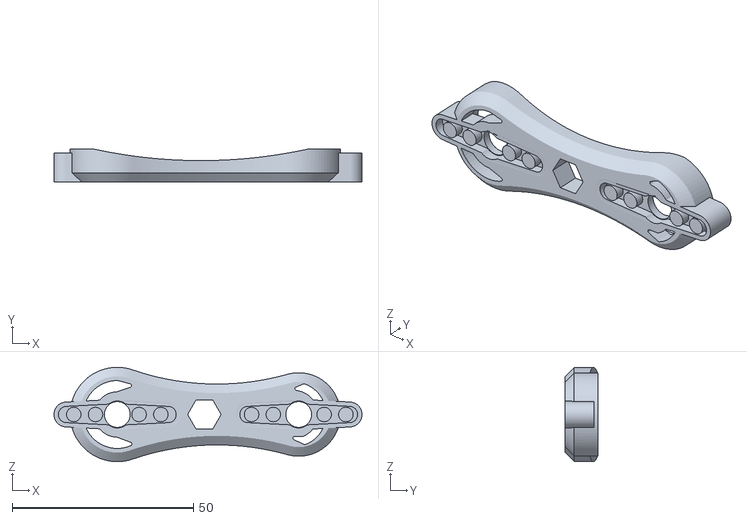
[picture p31: CAD file, 2026-10-23]
cad/custom/femur_double_with_supports.stl
84.9 x 9.00 x 26.0
