daniilpass/edog/cad/origin/Motor_Bloc_-_SG_90.stl

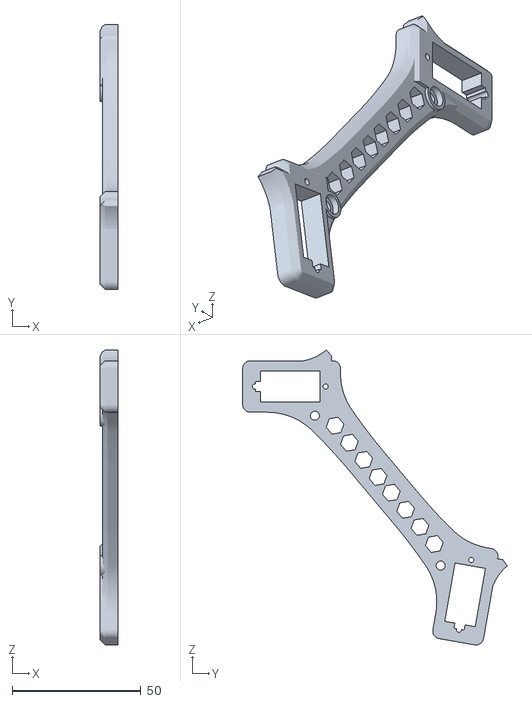
[picture p32: CAD file, 2026-10-15]
cad/origin/Motor_Bloc_-_SG_90.stl
7.00 x 102.8 x 114.6
