daniilpass/edog/cad/web/knee_servo_FL.stl

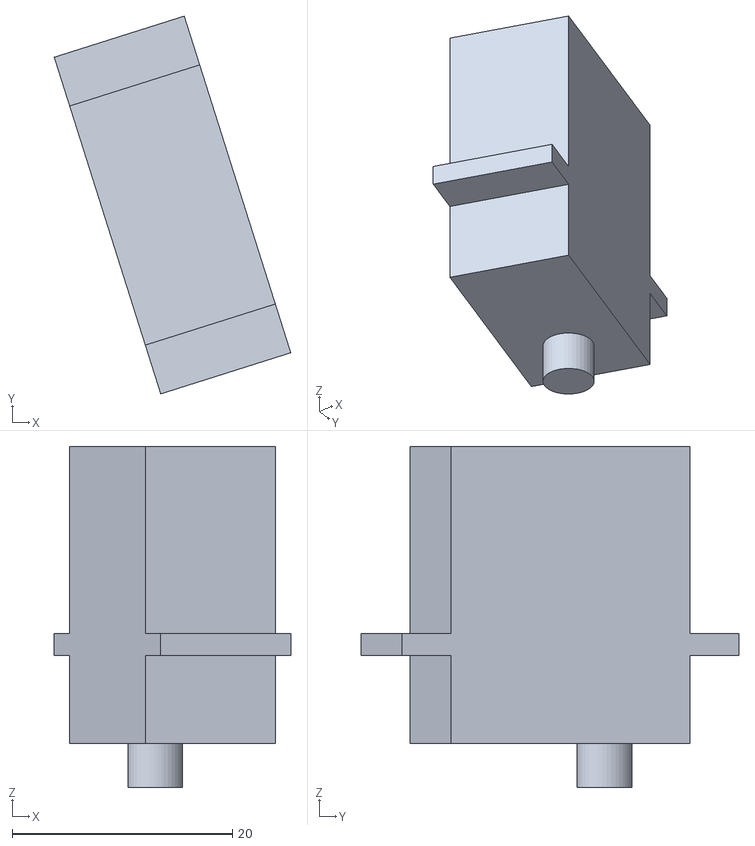
[picture p33: CAD file, 2026-10-18]
cad/web/knee_servo_FL.stl
21.5 x 34.3 x 31.0
