daniilpass/edog/cad/custom/tibia_insert.stl

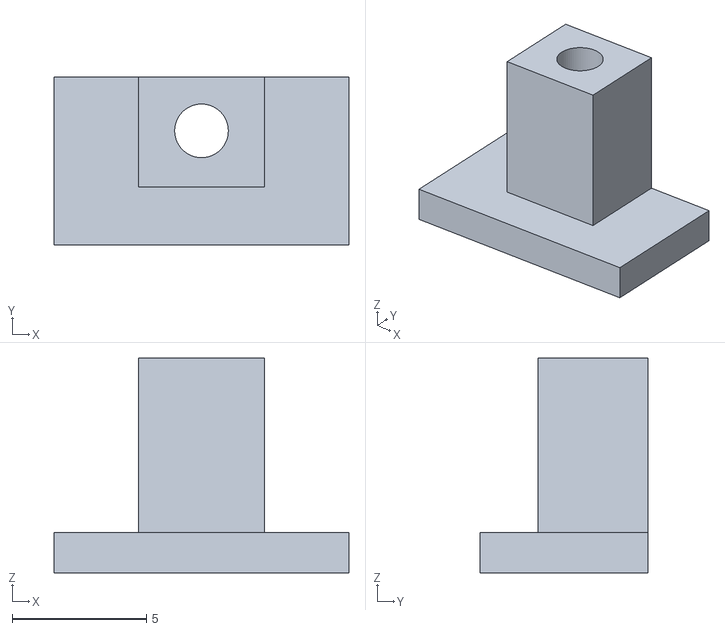
[picture p34: CAD file, 2026-10-18]
cad/custom/tibia_insert.stl
11.0 x 6.25 x 8.00
