daniilpass/edog/cad/web/tibia_FL.stl

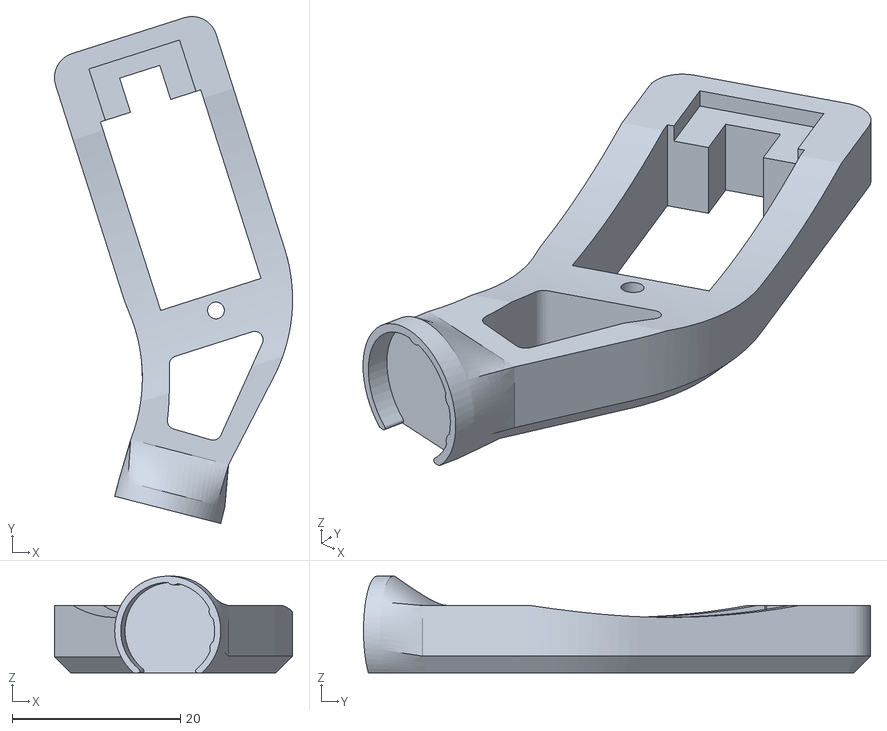
[picture p35: CAD file, 2026-10-18]
cad/web/tibia_FL.stl
28.3 x 60.2 x 11.5
