daniilpass/edog/cad/custom/motor_block.stl

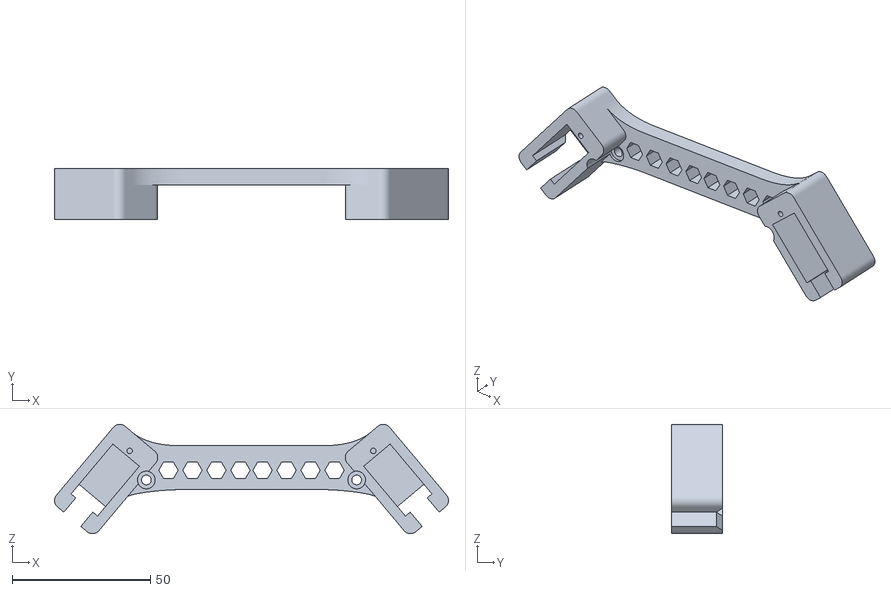
[picture p36: CAD file, 2026-10-18]
cad/custom/motor_block.stl
142.3 x 18.5 x 39.5
