daniilpass/edog/cad/custom/tibia.stl

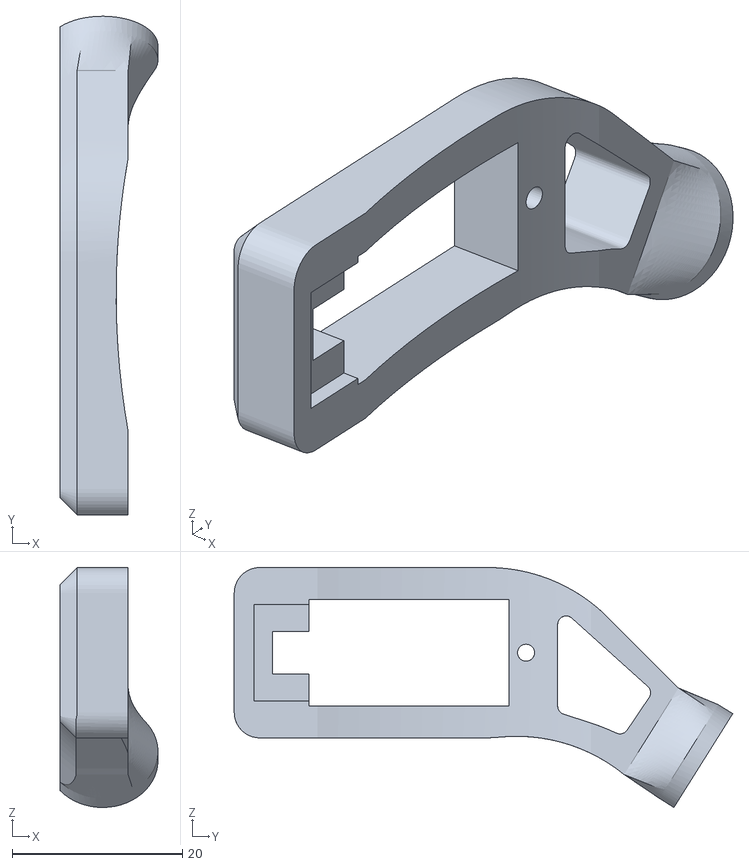
[picture p37: CAD file, 2026-10-18]
cad/custom/tibia.stl
11.5 x 58.5 x 28.2
