daniilpass/edog/cad/custom/motor_block_insert.stl

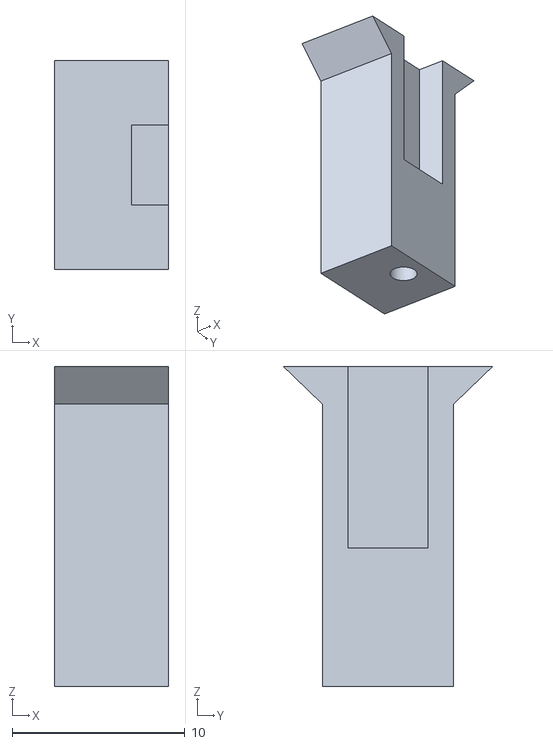
[picture p38: CAD file, 2026-10-18]
cad/custom/motor_block_insert.stl
6.60 x 12.1 x 18.5
