daniilpass/edog/cad/web/body.stl

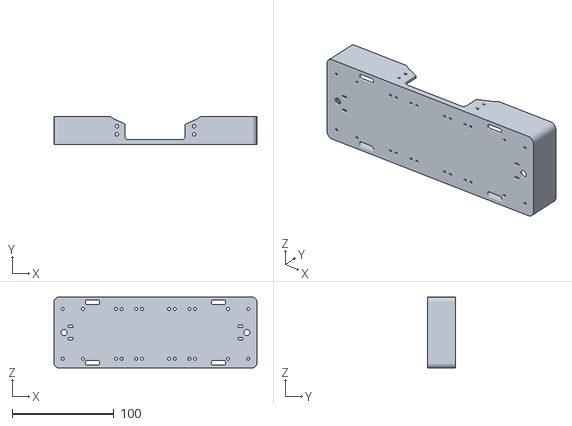
[picture p39: CAD file, 2026-10-18]
cad/web/body.stl
200.0 x 28.0 x 69.9
