daniilpass/edog/cad/custom/platform_small.stl

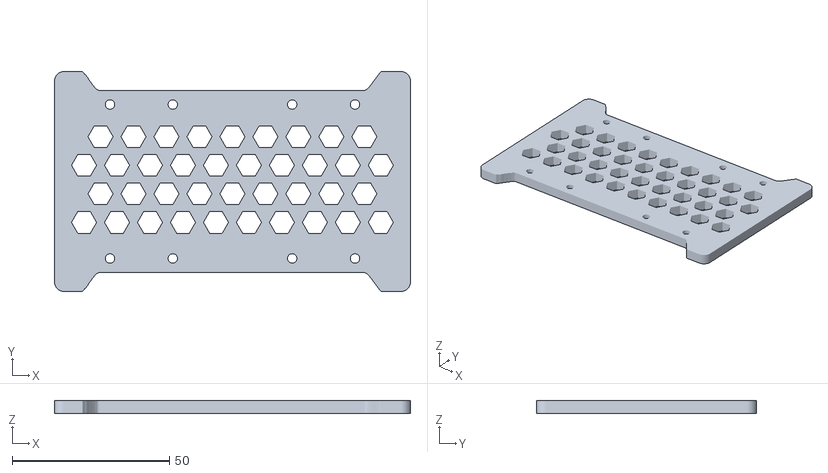
[picture p40: CAD file, 2026-10-15]
cad/custom/platform_small.stl
113.4 x 70.0 x 4.00
