daniilpass/edog/cad/web/hip_servos.stl

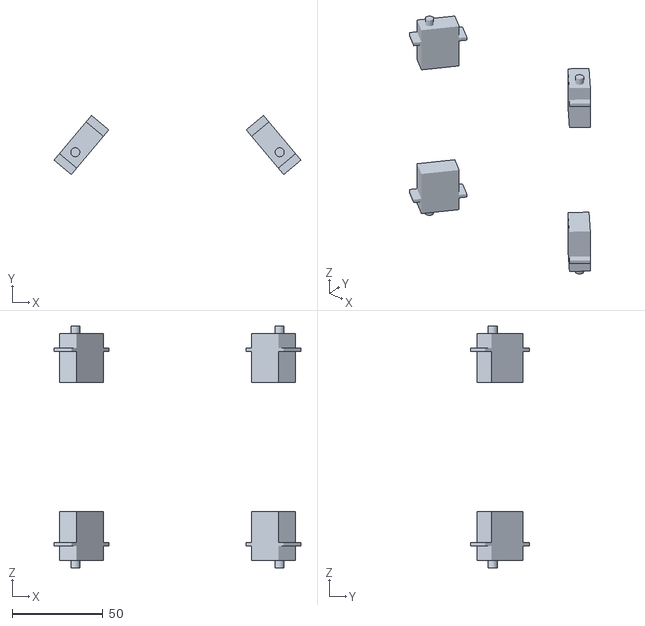
[picture p41: CAD file, 2026-10-18]
cad/web/hip_servos.stl
135.8 x 32.6 x 132.9
