daniilpass/edog/cad/web/frames.stl

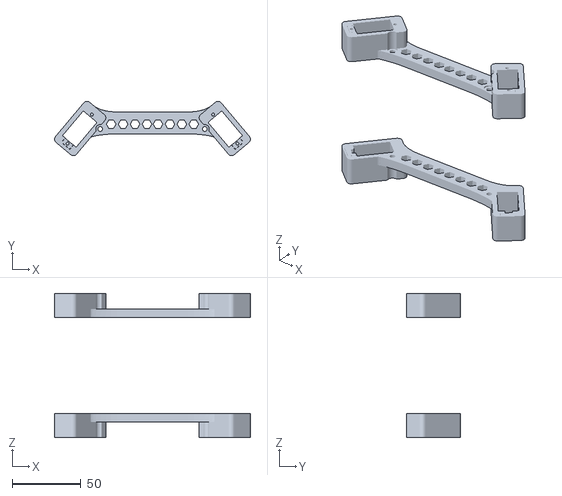
[picture p42: CAD file, 2026-10-18]
cad/web/frames.stl
142.3 x 39.5 x 104.9
