daniilpass/edog/cad/web/tibia_insert_FL.stl

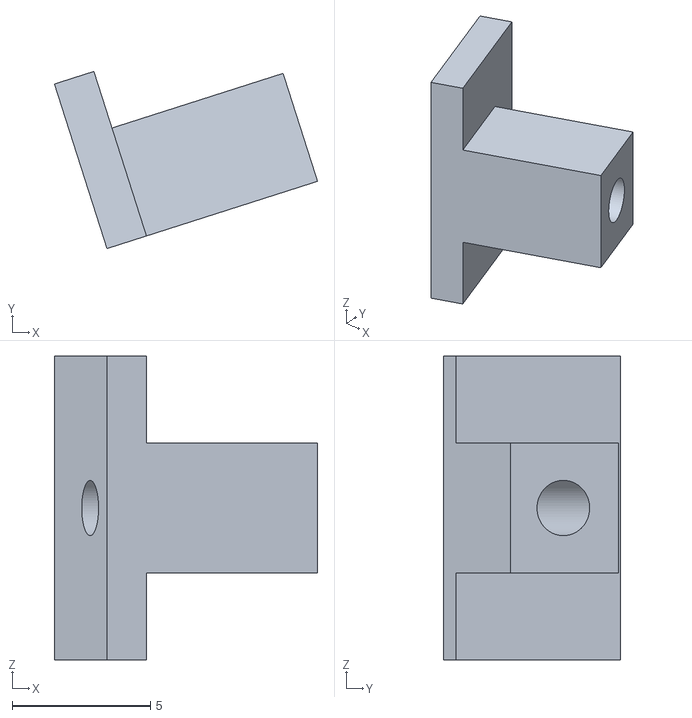
[picture p43: CAD file, 2026-10-18]
cad/web/tibia_insert_FL.stl
9.52 x 6.41 x 11.0
