daniilpass/edog/(list of files, cad)

Other CAD files:
cad/web/femur_FR.stl
cad/freecad/Femur_hub71_double.FCStd
cad/web/femur_RR.stl
cad/web/femur_RL.stl
cad/origin/Tibia_v2__-_VOTIK_7455.stl
cad/web/foot_pad_RR.stl
cad/web/foot_pad_FR.stl
cad/web/knee_servo_RR.stl
cad/custom/chassis_large.stl
cad/web/tibia_RR.stl
cad/custom/chassis_small.stl
cad/web/lid.stl
cad/web/knee_servo_FR.stl
cad/web/tibia_FR.stl
cad/web/tibia_insert_RR.stl
cad/web/tibia_insert_FR.stl
