daniilpass/edog/xiao/firmware/edog/leg_hull.h

// Оболочка узла колена в плоскости ноги (система колена: x вперёд, y вверх, мм).
// Сгенерировано из rpi/firmware/config/leg_hull.json (cad/web/make_leg_hull.py).
#pragma once

static const double HULL_FRAME_BOTTOM_MM = 0.52;
static const double HULL_FEMUR_MM = 50.0;
static const double HULL_KNEE[][2] = {{-13.39, 9.61}, {-13.36, 9.14}, {-6.24, -40.1}, {-6.19, -40.12}, {-5.92, -40.19}, {-4.99, -40.43}, {3.38, -42.58}, {5.33, -43.08}, {6.35, -43.34}, {13.63, -23.73}, {13.71, -23.5}, {13.97, -22.74}, {14.02, -22.58}, {14.2, -21.95}, {14.33, -21.42}, {14.39, -21.16}, {14.58, -20.23}, {14.69, -19.54}, {14.75, -19.04}, {14.78, -18.72}, {14.85, -17.9}, {14.88, -17.07}, {14.88, -16.63}, {14.87, -16.25}, {14.83, -15.42}, {14.76, -14.61}, {14.72, -14.22}, {14.66, -13.8}, {14.53, -13.02}, {14.35, -12.21}, {14.16, -11.44}, {13.93, -10.68}, {7.87, 8.3}, {5.8, 14.77}, {5.62, 15.2}, {5.38, 15.6}, {5.08, 15.96}, {4.72, 16.27}, {4.32, 16.52}, {3.89, 16.7}, {3.43, 16.81}, {2.96, 16.85}, {2.49, 16.82}, {2.03, 16.71}, {-11.3, 12.45}, {-11.67, 12.31}, {-12.01, 12.12}, {-12.14, 12.03}, {-12.4, 11.82}, {-12.5, 11.73}, {-12.73, 11.47}, {-12.81, 11.37}, {-13.01, 11.06}, {-13.06, 10.97}, {-13.21, 10.61}, {-13.24, 10.53}, {-13.34, 10.14}, {-13.35, 10.08}, {-13.39, 9.65}};
static const int HULL_KNEE_N = sizeof(HULL_KNEE) / sizeof(HULL_KNEE[0]);
