daniilpass/edog/xiao/firmware/edog/camera.cpp

#include "camera.h"

#include <Arduino.h>
#include <esp_heap_caps.h>
#include <freertos/semphr.h>

#include <atomic>

#include "config.h"
#include "esp_camera.h"
#include "esp_http_server.h"
#include "patrol.h"
#include "vision.h"

// Камера Sense (OV2640 / OV3660)
#define CAM_XCLK 10
#define CAM_SIOD 40
#define CAM_SIOC 39
#define CAM_Y9 48
#define CAM_Y8 11
#define CAM_Y7 12
#define CAM_Y6 14
#define CAM_Y5 16
#define CAM_Y4 18
#define CAM_Y3 17
#define CAM_Y2 15
#define CAM_VSYNC 38
#define CAM_HREF 47
#define CAM_PCLK 13

static const size_t FRAME_CAP = 160 * 1024;   // JPEG VGA при качестве 12 — обычно 30–60 КБ

static String sensor, error;
static std::atomic<uint32_t> frames{0}, captured{0};
static std::atomic<int> clients{0};
static std::atomic<bool> sleeping{false};   // сон: кадров нет, сенсор в режиме ожидания
// Поток один: сервер видео отдаёт его в одной задаче. Зритель — id из /stream?id=; другое устройство
// забирает поток через camera_take, текущий цикл видит чужой id и закрывает соединение.
static std::atomic<uint32_t> viewer{0};
static std::atomic<uint32_t> taken_ms{0};
static const uint32_t TAKE_HOLD_MS = 5000;   // столько поток держится за забравшим, пока тот подключается

// Последний кадр: его забирают поток видео и зрение. Сенсор снимает непрерывно, задача захвата
// копирует каждый кадр сюда и отдаёт зрению с отметкой времени съёмки.
static uint8_t *latest_buf;
static size_t latest_len;
static double latest_t;
static uint32_t latest_seq;
static SemaphoreHandle_t latest_lock;

// Кто смотрит или вот-вот подключится; 0 — поток свободен.
static uint32_t current_viewer() {
  if (clients == 0 && millis() - taken_ms > TAKE_HOLD_MS) return 0;
  return viewer;
}

void camera_take(uint32_t id) {
  taken_ms = millis();
  viewer = id;
}

int camera_clients() { return clients; }

uint32_t camera_latest(uint8_t *buf, size_t cap, size_t &len, double &t, uint32_t after, uint32_t wait_ms) {
  uint32_t start = millis();
  for (;;) {
    xSemaphoreTake(latest_lock, portMAX_DELAY);
    uint32_t seq = latest_seq;
    if (seq != after && latest_len && latest_len <= cap) {
      memcpy(buf, latest_buf, latest_len);
      len = latest_len;
      t = latest_t;
      xSemaphoreGive(latest_lock);
      return seq;
    }
    xSemaphoreGive(latest_lock);
    if (millis() - start >= wait_ms) return 0;
    delay(5);
  }
}

static void capture_task(void *) {
  for (;;) {
    if (sleeping) {
      delay(100);
      continue;
    }
    camera_fb_t *fb = esp_camera_fb_get();
    if (!fb) {
      delay(10);
      continue;
    }
    double t = fb->timestamp.tv_sec + fb->timestamp.tv_usec / 1e6;   // начало кадра, часы esp_timer
    if (fb->len <= FRAME_CAP) {
      xSemaphoreTake(latest_lock, portMAX_DELAY);
      memcpy(latest_buf, fb->buf, fb->len);
      latest_len = fb->len;
      latest_t = t;
      latest_seq++;
      if (!latest_seq) latest_seq = 1;   // 0 — «нет кадра»
      xSemaphoreGive(latest_lock);
      vision_on_frame(fb->buf, fb->len, t);
    }
    esp_camera_fb_return(fb);
    captured++;
  }
}

static esp_err_t stream_handler(httpd_req_t *req) {
  char query[64], value[16];
  uint32_t id = 0;   // без id (VLC и т. п.) — безымянный зритель, его тоже можно сменить
  if (httpd_req_get_url_query_str(req, query, sizeof query) == ESP_OK &&
      httpd_query_key_value(query, "id", value, sizeof value) == ESP_OK)
    id = strtoul(value, nullptr, 10);
  httpd_resp_set_hdr(req, "Access-Control-Allow-Origin", "*");
  if (sleeping) {
    httpd_resp_set_status(req, "503 Service Unavailable");
    return httpd_resp_sendstr(req, "dog is asleep");
  }
  uint32_t v = current_viewer();
  if (v && v != id) {   // поток только что забрало другое устройство
    httpd_resp_set_status(req, "409 Conflict");
    return httpd_resp_sendstr(req, "video taken by another viewer");
  }
  viewer = id;

  uint8_t *jpeg = (uint8_t *)heap_caps_malloc(FRAME_CAP, MALLOC_CAP_SPIRAM);
  if (!jpeg) {
    httpd_resp_set_status(req, "503 Service Unavailable");
    return httpd_resp_sendstr(req, "no memory");
  }
  httpd_resp_set_type(req, "multipart/x-mixed-replace;boundary=frame");
  httpd_resp_set_hdr(req, "Cache-Control", "no-store");
  const uint32_t period = 1000 / CAMERA_FPS;
  static char part[1536];   // поток один, обработчик сервера видео — тоже
  clients++;
  uint32_t next = millis(), seq = 0;
  while (viewer == id) {
    int32_t wait = (int32_t)(next - millis());
    if (wait > 0) delay(wait);
    next += period;
    if ((int32_t)(millis() - next) > (int32_t)period) next = millis();   // не догонять пропущенные кадры
    size_t len;
    double t;
    uint32_t got = camera_latest(jpeg, FRAME_CAP, len, t, seq, 1000);
    if (!got) break;
    seq = got;
    // Заголовки кадра: что увидело зрение (рамки, пол) и что делает патруль — портал и приложение рисуют поверх.
    int hl = snprintf(part, sizeof part, "\r\n--frame\r\nContent-Type: image/jpeg\r\nContent-Length: %u\r\n", len);
    hl += vision_headers(part + hl, sizeof part - hl - 4);
    hl += patrol_headers(part + hl, sizeof part - hl - 4);
    hl += snprintf(part + hl, sizeof part - hl, "\r\n");
    esp_err_t r = httpd_resp_send_chunk(req, part, hl);
    if (r == ESP_OK) r = httpd_resp_send_chunk(req, (const char *)jpeg, len);
    if (r != ESP_OK) break;   // портал закрыт
    frames++;
  }
  clients--;
  heap_caps_free(jpeg);
  if (viewer != id) {   // забрали: закрыть соединение сразу, а не ждать таймаута у прежнего зрителя
    httpd_resp_send_chunk(req, nullptr, 0);
    httpd_sess_trigger_close(req->handle, httpd_req_to_sockfd(req));
  }
  viewer.compare_exchange_strong(id, 0);   // ушёл сам — поток свободен; забрали — id уже чужой
  return ESP_OK;
}

void camera_begin() {
  camera_config_t c = {};
  c.ledc_channel = LEDC_CHANNEL_0;
  c.ledc_timer = LEDC_TIMER_0;
  c.pin_d0 = CAM_Y2; c.pin_d1 = CAM_Y3; c.pin_d2 = CAM_Y4; c.pin_d3 = CAM_Y5;
  c.pin_d4 = CAM_Y6; c.pin_d5 = CAM_Y7; c.pin_d6 = CAM_Y8; c.pin_d7 = CAM_Y9;
  c.pin_xclk = CAM_XCLK; c.pin_pclk = CAM_PCLK;
  c.pin_vsync = CAM_VSYNC; c.pin_href = CAM_HREF;
  c.pin_sccb_sda = CAM_SIOD; c.pin_sccb_scl = CAM_SIOC;
  c.sccb_i2c_port = 1;   // порт 0 — Wire, PCA9685
  c.pin_pwdn = -1; c.pin_reset = -1;
  c.xclk_freq_hz = 20000000;
  c.pixel_format = PIXFORMAT_JPEG;
  c.frame_size = CAMERA_FRAMESIZE;
  c.jpeg_quality = CAMERA_QUALITY;
  c.fb_count = 2;
  c.fb_location = CAMERA_FB_IN_PSRAM;
  c.grab_mode = CAMERA_GRAB_LATEST;   // свежий кадр, а не из очереди

  esp_err_t err = esp_camera_init(&c);
  if (err != ESP_OK) {
    error = "ошибка инициализации 0x" + String(err, HEX);
    Serial.printf("Камера: %s\n", error.c_str());
    return;
  }
  sensor_t *s = esp_camera_sensor_get();
  s->set_vflip(s, CAMERA_VFLIP);
  s->set_hmirror(s, CAMERA_HMIRROR);
  switch (s->id.PID) {
    case OV2640_PID: sensor = "OV2640"; break;
    case OV3660_PID: sensor = "OV3660"; break;
    case OV5640_PID: sensor = "OV5640"; break;
    default: sensor = "0x" + String(s->id.PID, HEX);
  }

  latest_lock = xSemaphoreCreateMutex();
  latest_buf = (uint8_t *)heap_caps_malloc(FRAME_CAP, MALLOC_CAP_SPIRAM);
  xTaskCreatePinnedToCore(capture_task, "capture", 6144, nullptr, 4, nullptr, 0);

  httpd_config_t cfg = HTTPD_DEFAULT_CONFIG();
  cfg.server_port = STREAM_PORT;
  cfg.ctrl_port = 32768 + STREAM_PORT;
  cfg.max_open_sockets = 3;
  cfg.lru_purge_enable = true;
  httpd_handle_t h = nullptr;
  if (httpd_start(&h, &cfg) != ESP_OK) {
    error = "не запустился сервер видео";
    Serial.printf("Камера: %s\n", error.c_str());
    return;
  }
  httpd_uri_t u = {};
  u.uri = "/stream";
  u.method = HTTP_GET;
  u.handler = stream_handler;
  httpd_register_uri_handler(h, &u);
  Serial.printf("Камера %s: http://<адрес>:%d/stream, %d кадр/с\n", sensor.c_str(), STREAM_PORT, CAMERA_FPS);
}

// Вывода питания (PWDN) у Sense нет: сенсор усыпляется регистром по SCCB, тактирование остаётся.
void camera_sleep(bool on) {
  if (sensor.isEmpty() || sleeping == on) return;
  if (on) sleeping = true;   // сначала задача захвата перестаёт ждать кадры
  sensor_t *s = esp_camera_sensor_get();
  if (s->id.PID == OV2640_PID) s->set_reg(s, 0x109, 0x10, on ? 0x10 : 0);   // банк сенсора, COM2[4]: standby
  else s->set_reg(s, 0x3008, 0x40, on ? 0x40 : 0);                         // OV3660/OV5640: SYSTEM CTROL0[6]
  if (!on) sleeping = false;
  Serial.printf("Камера: %s\n", on ? "режим ожидания" : "снимает");
}

void camera_describe(JsonObject out) {
  out["ok"] = error.isEmpty() && !sensor.isEmpty();
  if (!error.isEmpty()) out["error"] = error;
  out["sensor"] = sensor;
  out["port"] = STREAM_PORT;
  out["path"] = "/stream";
  out["fps"] = CAMERA_FPS;
  out["width"] = 640;
  out["height"] = 480;
}

void camera_state(JsonObject out) {
  static uint32_t last_frames = 0, last_captured = 0, last_ms = 0;
  static float fps = 0, sensor_fps = 0;
  uint32_t now = millis();
  if (now - last_ms >= 1000) {
    fps = last_ms ? (frames - last_frames) * 1000.0f / (now - last_ms) : 0;
    sensor_fps = last_ms ? (captured - last_captured) * 1000.0f / (now - last_ms) : 0;
    last_frames = frames;
    last_captured = captured;
    last_ms = now;
  }
  out["fps"] = std::round(fps * 10) / 10.0;
  out["sensor_fps"] = std::round(sensor_fps * 10) / 10.0;
  out["clients"] = clients.load();
  out["viewer"] = current_viewer();
}
