daniilpass/edog/rpi/firmware/edog/api.py

"""REST + WebSocket API. Веб-портал хостится отдельно (ui/ в корне репозитория), на Pi — только API."""

import asyncio
import json
import logging
from typing import Literal

from fastapi import FastAPI, HTTPException, WebSocket, WebSocketDisconnect
from fastapi.middleware.cors import CORSMiddleware
from pydantic import BaseModel, Field

from . import bluetooth

log = logging.getLogger(__name__)

STATE_HZ = 20


class EnableReq(BaseModel):
    enabled: bool


class ModeReq(BaseModel):
    mode: Literal["stand", "manual"]


class BodyReq(BaseModel):
    height: float | None = None
    pitch: float | None = None
    roll: float | None = None


class DriveReq(BaseModel):
    vx: float = Field(0, ge=-1, le=1)
    turn: float = Field(0, ge=-1, le=1)


class ServoReq(BaseModel):
    angle: float | None = Field(None, description="угол серво, °")
    joint: float | None = Field(None, description="угол сустава, °")


class CalibrationReq(BaseModel):
    installed: bool | None = None
    zero: float | None = None
    scale: float | None = Field(None, description="градусов серво на градус сустава")
    dir: Literal[-1, 1] | None = None
    min_deg: float | None = None
    max_deg: float | None = None


class TestReq(BaseModel):
    action: Literal["center", "ref", "sweep", "stop", "nudge"]
    delta: float = Field(0, ge=-30, le=30, description="для nudge: шаг, °")


class PowerReq(BaseModel):
    limit_a: float | None = Field(None, ge=0, le=50, description="лимит БП серво, А; 0 — без ограничения")
    servo_a: float | None = Field(None, gt=0, le=5, description="пиковый ток одного серво, А")


class TrimReq(BaseModel):
    pitch_deg: float | None = Field(None, ge=-10, le=10, description="поправка тангажа, °, + — нос вверх")
    roll_deg: float | None = Field(None, ge=-10, le=10, description="поправка крена, °, + — правый борт ниже")


class DemoReq(BaseModel):
    action: Literal["start", "stop"]
    cycles: int = Field(4, ge=1, le=20, description="сколько полных циклов шага делает каждая нога (группа)")
    laps: int = Field(3, ge=1, le=20, description="кругов по ногам")


class GaitReq(BaseModel):
    name: str = Field(..., description="профиль ходьбы из [gaits] в config.toml")


class MacReq(BaseModel):
    mac: str


class CalibrateReq(BaseModel):
    joint: float = Field(..., description="угол сустава, который нога физически показывает сейчас")
    what: Literal["zero", "scale"] = Field("zero", description="zero — сдвиг; scale — вторая точка, "
                                           "масштаб при неподвижном монтажном положении")


def create_app(robot) -> tuple[FastAPI, callable]:
    app = FastAPI(title="EDOG", version="0.2")
    # Портал открывается с другого адреса (ПК), поэтому API доступно с любого origin.
    # Авторизации нет: рассчитано на домашнюю сеть.
    app.add_middleware(CORSMiddleware, allow_origins=["*"], allow_methods=["*"], allow_headers=["*"])
    clients: set[WebSocket] = set()

    def servo_call(fn, *args, **kwargs):
        try:
            fn(*args, **kwargs)
        except KeyError as e:
            raise HTTPException(404, f"нет такого: {e}")
        except ValueError as e:
            raise HTTPException(400, str(e))
        return robot.state()

    @app.get("/")
    def root():
        return {"service": "edog", "api": "/api", "docs": "/docs", "ws": "/ws",
                "ui": "портал запускается на ПК: python ui/serve.py"}

    @app.get("/api/config")
    def get_config():
        return robot.describe()

    @app.get("/api/state")
    def get_state():
        return robot.state()

    @app.post("/api/enable")
    def enable(req: EnableReq):
        return servo_call(robot.set_enabled, req.enabled)

    @app.post("/api/estop")
    def estop():
        return servo_call(robot.estop)

    @app.post("/api/mode")
    def mode(req: ModeReq):
        return servo_call(robot.set_mode, req.mode)

    @app.post("/api/pose/{name}")
    def pose(name: str):
        return servo_call(robot.set_pose, name)

    @app.post("/api/move/{name}")
    def move(name: str):
        return servo_call(robot.start_move, name)

    @app.post("/api/demo")
    def demo(req: DemoReq):
        """Демо: ноги по кругу шагают в воздухе; сколько ног сразу — по лимиту тока."""
        if req.action == "start":
            return servo_call(robot.start_demo, req.cycles, req.laps)
        return servo_call(robot.stop_demo)

    @app.post("/api/gait")
    def gait(req: GaitReq):
        """Профиль ходьбы: им шагают и ходьба, и демо. В файл — /api/calibration/save."""
        return servo_call(robot.set_gait, req.name)

    @app.post("/api/body")
    def body(req: BodyReq):
        return servo_call(robot.set_body, req.height, req.pitch, req.roll)

    @app.post("/api/drive")
    def drive(req: DriveReq):
        return servo_call(robot.set_web_drive, req.vx, req.turn)

    @app.put("/api/servos/{sid}")
    def set_servo(sid: str, req: ServoReq):
        if (req.angle is None) == (req.joint is None):
            raise HTTPException(400, "нужно ровно одно из: angle, joint")
        return servo_call(robot.set_servo, sid, req.angle, req.joint)

    @app.post("/api/servos/{sid}/test")
    def test_servo(sid: str, req: TestReq):
        if req.action == "nudge":
            return servo_call(robot.nudge, sid, req.delta)
        return servo_call(robot.test_servo, sid, req.action)

    @app.patch("/api/servos/{sid}/calibration")
    def patch_calibration(sid: str, req: CalibrationReq):
        return servo_call(robot.update_calibration, sid, **req.model_dump())

    @app.post("/api/servos/{sid}/calibrate")
    def calibrate(sid: str, req: CalibrateReq):
        return servo_call(robot.calibrate, sid, req.joint, req.what)

    @app.post("/api/calibration/save")
    def save_calibration():
        return {"saved": robot.save_calibration()}

    @app.patch("/api/power")
    def patch_power(req: PowerReq):
        return servo_call(robot.update_power, req.limit_a, req.servo_a)

    @app.patch("/api/trim")
    def patch_trim(req: TrimReq):
        return servo_call(robot.update_trim, req.pitch_deg, req.roll_deg)

    @app.get("/api/bluetooth/scan")
    async def bt_scan(seconds: int = 8):
        try:
            return {"devices": await bluetooth.scan(max(2, min(seconds, 30)))}
        except bluetooth.BluetoothError as e:
            raise HTTPException(503, str(e))

    @app.post("/api/bluetooth/pair")
    async def bt_pair(req: MacReq):
        try:
            return {"log": await bluetooth.pair(req.mac)}
        except bluetooth.BluetoothError as e:
            raise HTTPException(502, str(e))

    @app.post("/api/bluetooth/remove")
    async def bt_remove(req: MacReq):
        try:
            return {"log": await bluetooth.remove(req.mac)}
        except bluetooth.BluetoothError as e:
            raise HTTPException(502, str(e))

    @app.websocket("/ws")
    async def ws(socket: WebSocket):
        """Сервер шлёт состояние 20 раз в секунду. Клиент может слать
        {"type": "drive", "vx", "turn"} и {"type": "servo", "id", "angle"|"joint"}."""
        await socket.accept()
        clients.add(socket)
        try:
            while True:
                msg = await socket.receive_json()
                try:
                    if msg.get("type") == "drive":
                        robot.set_web_drive(float(msg.get("vx", 0)), float(msg.get("turn", 0)))
                    elif msg.get("type") == "servo":
                        robot.set_servo(msg["id"], msg.get("angle"), msg.get("joint"))
                except (KeyError, ValueError, TypeError) as e:
                    await socket.send_json({"type": "error", "message": str(e)})
        except (WebSocketDisconnect, json.JSONDecodeError):
            pass
        finally:
            clients.discard(socket)

    async def broadcast() -> None:
        while True:
            await asyncio.sleep(1 / STATE_HZ)
            if not clients:
                continue
            text = json.dumps({"type": "state", **robot.state()})
            for socket in list(clients):
                try:
                    await socket.send_text(text)
                except Exception:
                    clients.discard(socket)

    return app, broadcast
