daniilpass/edog/(commit log)

2026-10-17 corpus cads
    [EDOG_F_Cylinder_OutboardServos.FCStd, EDOG_G_ExternalServoSeats.FCStd, EDOG_H_RoundedBody_200mm.FCStd, EDOG_I_RoundedBody_Working.FCStd, EDOG_J_InternalElectronics_Working.FCStd, EDOG_K_WidenedEnds.FCStd, EDOG_L_Stacked_DCDC.FCStd, EDOG_M_Captive_M3_Nuts.FCStd]
2026-10-18 update CADs and firmware draft
    [EDOG_Q_Chassis_Lightening.FCStd, EDOG_R_Servo_Fit.FCStd, EDOG_S_Web_Assembly.FCStd, EDOG_T_Front_Mark.FCStd, Femur_hub7.stl, Femur_hub7_test.stl, Tibia_v2_SG90_fit.FCStd, Tibia_v2_SG90_fit.stl]
2026-10-18 Deploy to Pi without git, SSH skill, power measurements
    - firmware/os/deploy.sh: ship only firmware/ and cad/web/ to the Pi over SSH,
    keep venv and calibration.json, restart and verify the service
    - .claude/skills/edog-pi: SSH access, service/logs, deploy, power checks
    - docs/hardware.md: RPi undervoltage measurements on LM2596 via micro-USB
    - firmware/README.md: install and update via deploy.sh
2026-10-18 Pi serves API only; local UI; frame guard; hip servo flip
    Architecture
    - firmware: API only (REST, WebSocket, /docs) with CORS; static portal removed
    - ui/: portal moved out of firmware, served on PC by ui/serve.py
    (models from cad/web at /models/); dog address via header field or ?dog=, kept in localStorage
    - deploy.sh ships firmware/ only, syncs to SD, rejects empty files, waits for API
    Kinematics and safety
    - knee angle measured along tibia body; tibia bend (17.7 deg) handled in ik/fk
    - hip servos flipped 180 deg in CAD (shaft at frame ends): hips at +-56.2 mm
    - frame guard: knee assembly stays below frame bar plane minus margin,
    checked every control step and on manual commands (col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
    [EDOG_S_Web_Assembly.FCStd, EDOG_T_Front_Mark.FCStd, body.stl, femur_RL.stl, femur_RR.stl, frames.stl, hip_servos.stl, knee_servo_FL.stl]
2026-10-19 Femur: screw holes 6 mm from existing, 1 mm deeper recesses, print supports
    - Femur_hub7_screw6: extra Ø2 screw hole per horn seat, 6 mm from the old one;
    Ø21 recesses lowered by 1 mm
    - Femur_hub7_screw6_supports: same with Ø4 cylinder supports under screw holes, 0.2 mm gap
    - EDOG_R_Servo_Fit.FCStd update
    [EDOG_R_Servo_Fit.FCStd, Femur_hub7_screw6.FCStd, Femur_hub7_screw6.stl, Femur_hub7_screw6_supports.stl]
2026-10-19 Servo current limit: cap installed servos by PSU amps
    Portal and API allow marking at most limit_a / servo_a servos as installed;
    settings persist in calibration.json without saving pending servo calibration.
2026-10-19 Portal: one header Save; foot pads in 3D model
    Save button is always visible in the header and writes servo calibration,
    installed flags and the current limit together; Apply no longer saves.
    Power fields keep typed values until applied; inputs use text color.
    Also: rubber foot pads (Ø10×5 hemisphere) exported to cad/web and shown
    in the portal; Femur_hub7_screw6.FCStd updated.
    [Femur_hub7_screw6.FCStd, foot_pad_FL.stl, foot_pad_FR.stl, foot_pad_RL.stl, foot_pad_RR.stl]
2026-10-20 servo pins
2026-10-20 Config: hip servos reversed by default
    Verified on the assembled legs: every hip needed its dir flipped.
2026-10-20 Demo: legs take turns stepping in the air, group size from PSU limit
    Each leg (or diagonal pair, or all four) steps for 3 s with the walking
    foot trajectory, then the next group takes over. Only the stepping legs
    get a signal, so the 3 A servo supply is never exceeded. Portal gets a
    Demo button; tools/dance.py runs the same demo from a console.
2026-10-20 Gait profiles; demo shows the chosen one, 4 cycles per leg from FR
    Walking parameters move into [gaits.*] profiles: base keeps the old
    walk, wide/max take bigger steps with a higher servo speed limit, and
    wide_slow/max_slow take the same steps slower within 300 deg/s. The
    portal picks the profile next to the Demo button and shows the expected
    speed, joint swing and whether the servo speed limit cuts the step.
    The choice is saved with calibration.
    Demo starts from the front right leg and steps 4 full gait cycles per
    leg (group) instead of a fixed number of seconds.
    [api.py, config.py, demo.py, robot.py, test_core.py]
2026-10-22 Gamepad: Xbox layout, walk always on, triggers for height; safe power on/off
    - Xbox BT: X/Y were swapped (X = BTN_NORTH, Y = BTN_WEST); Y now "high"
    pose; right stick is ABS_Z/ABS_RZ
    - No separate walk mode: stick or arrows always walk, switching to the
    stand pose first; left stick gives direction only (full stride), the
    stronger axis wins, larger deadzone
    - Triggers lower/raise the body while held; d-pad no longer used
    - Servos off: joints go to the mounting position first, then signal is
    cut (estop still cuts at once); servos on: from mounting position into
    stand
    - deploy.sh powers servos down gracefully before restarting the service
    - motion loop at 100 Hz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
    [api.py, gamepad.py, robot.py, test_core.py]
2026-10-22 Moves: jump straight up (d-pad up, portal button), then stand
    - Moves are step sequences (body height, hold time, servo speed); any
    pose/body/power command interrupts them; stand pose at the end
    - Jump: shallow crouch, all legs push to a straight leg with no speed
    limit (full servo torque from the start), back to stand
    - POST /api/move/{name}; config lists moves, state shows the current one
    - Gamepad d-pad mapped via [gamepad.dpad]; up = jump
2026-10-22 Gaits: 3-leg crawl with body sway, foot offset and height per profile; trim; mount pose
    - crawl: legs one at a time (left pair, then right), body sways fore-aft and
    shifts sideways by roll, roll changes slowly while all four feet are down
    - gait profiles may set height_mm and foot_x_mm (foot offset only when walking
    forward: backward trot with feet behind the hips steps in place)
    - base trot: feet 10 mm behind the hips against falling onto the rear legs;
    base_slow to watch the mechanics; stopper* profiles keep the sole on the pad
    - calibration: pitch/roll trim for assembly tolerances (portal card, saved)
    - "mount" pose: all joints to the mounting position
    - portal shows true gait speed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
    [api.py, config.py, gamepad.py, robot.py, test_core.py]
2026-10-22 Moves: joy (high <-> stand 4 times, full speed; d-pad down, portal button); repeat pose button returns to stand
2026-10-23 Femur: double-sided horn, shaft hole 7.1, far screws 1.5; portal femur model
    [Femur_hub71_double.FCStd, Femur_hub71_double.stl, Femur_hub71_double_supports.stl, femur_FL.stl, femur_FR.stl, femur_RL.stl, femur_RR.stl]
2026-10-23 Gaits: keep only base and stopper profiles (+ slow); base foot_x -15; default gait base
    base: foot_x -10 fell onto the lifted rear leg, -20 pitched nose down.
    Femur_hub71_double model update.
    [Femur_hub71_double.FCStd]
2026-10-23 Gaits: per-profile stand, base on stoppers, walk always starts from stand
    - each gait has its own stand (height_mm, foot_x_mm); choosing a gait while
    standing moves to it; feet go under the hip only when walking backward
    - new profiles base_stopper (+ slow): base at 78 mm so the stopper touches
    - leg joints reach targets together: stand -> sit no longer hits the frame
    - walking starts at phase 0 (FL+RR first) only after servos settle in stand;
    releasing the stick returns to stand at once
    [robot.py, test_core.py]
2026-10-23 Gamepad: Share cycles gaits (skips *_slow), bumpers add roll ±1° until power off; portal render fix
    - Share/Back: next gait profile; e-stop stays in the portal (button, Space)
    - LB/RB: constant roll offset, reset when servos switch off; shown next to the roll slider
    - portal: body.foot_x broke render() (no element), servos looked switched off
    [gamepad.py, robot.py, test_core.py]
2026-10-23 Calibration: per-servo scale (second point under load), load pose; manual servo leaves pose
2026-10-24 CAD: XIAO ESP32-S3 layout — deck, camera mount, PCA frame
    EDOG_V_XIAO_Layout: chassis_large unchanged; LiPo on lid, PCA on edge with
    L-frame, deck for UBEC 8A and DC 2xUSB, XIAO Sense mast (USB-C down) with
    front cover holding the lens. Seeed STEP of the XIAO Sense in cad/vendor.
    [EDOG_V_XIAO_Layout.FCStd, pca_brackets.stl, xiao_camera_cover.stl, xiao_camera_mast.stl, xiao_deck.stl]
2026-10-24 CAD README: XIAO ESP32-S3 layout, print notes
2026-10-24 Layout: rpi/ and xiao/ folders, shared portal ui/; XIAO ESP32-S3 Sense test firmware
    - firmware/, tools/ -> rpi/; deploy.sh packs from rpi/ with firmware/ paths, so the Pi keeps ~/edog/firmware
    - ui/ and start.cmd stay in the root as the portal shared by RPi and XIAO
    - xiao/firmware/xiao_test: API only (status, camera control, Wi-Fi scan/save), MJPEG on :81, PCM audio on :82,
    AP fallback EDOG-XIAO; xiao/ui: diagnostics page served from the PC on :8001
    - ignore *.secret (Wi-Fi credentials)
2026-10-24 CAD: rename custom STLs, XIAO stand with cap instead of camera mast
    - cad/custom: motor_block*, tibia*, femur_with_supports, femur_double_with_supports,
    dc_deck; non-support femur variants removed
    - xiao_stand + xiao_stand_cap (and test top) replace xiao_camera_mast/cover;
    EDOG_V_XIAO_Layout updated
    - export_web_models.py: femur from Femur_double_horn in Femur_hub71_double.FCStd,
    tibia from tibia*.stl
    - READMEs, docs and comments use the new file names
    [EDOG_V_XIAO_Layout.FCStd, Femur_hub7.stl, Femur_hub71_double.stl, Femur_hub7_screw6.stl, dc_deck.stl, femur_double_with_supports.stl, femur_with_supports.stl, motor_block.stl]
2026-10-24 cad models fox xiao
    [EDOG_V_XIAO_Layout.FCStd, xiao_stand.stl, xiao_stand_TEST_top.stl, xiao_stand_with_supports.stl]
2026-10-24 XIAO ESP32-S3 Sense firmware: port of the RPi service, video, OTA
    Firmware xiao/firmware/edog: robot loop, gaits, moves, demo, calibration,
    power limit and frame guard ported from rpi/firmware one to one; same REST +
    WebSocket API on :8080, MJPEG camera stream on :8081; BLE HID gamepad with
    pairing from the portal and evdev-style key names; calibration in NVS with
    import of calibration.json from the Pi; OTA via POST /api/firmware and
    xiao/ota.py. Servo channels moved: FL 4/5, RL 6/7, FR 8/9, RR 10/11.
    Portal: camera block, calibration import, firmware update, grid gap fix.
    Also: calibration.json copied from the Pi, Android video app, CAD updates.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
    [femur_FL.stl, femur_FR.stl, femur_RL.stl, femur_RR.stl, gamepad_phone_holder_fold6.stl]
2026-10-24 XIAO: fix gamepad input lag, OTA powers servos down instead of refusing
    - BLE connection interval 7.5-15 ms: NimBLE kept 30-50 ms and answered the
    gamepad's update request with the same values, reports queued up in the pad
    - OTA with servos on: the dog goes to the mount pose and drops the signal
    first, as with the RPi deploy; ota.py and the portal no longer refuse
    [api.cpp, gamepad.cpp, robot.cpp]
2026-10-24 XIAO: mirror camera image horizontally
2026-10-24 Autonomous camera patrol on XIAO: person detection, floor vision, radar
    Firmware (xiao/firmware/edog):
    - vision: ESP-DL pedestrian_detect embedded in flash, own input fill
    instead of ImagePreprocessor (saves ~650 KB), floor segmentation,
    closeness, frame alignment/expansion/stagnation, gait-phase-synced frames
    - patrol: state machine (walk, scan, approach, greet, leave, backup),
    local 16-sector map, visual novelty memory, wall following,
    autostart on power-on only, pause on human input, d-pad right toggle
    - moves nod/wag/bow; single capture task feeds stream and vision;
    stream frames carry X-Detect/X-Free/X-Vision/X-Patrol/X-Map headers
    - API starts first; OTA image stays on probat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
2026-10-25 CAD: faceted body shell with EDOG lettering and XIAO visor
    Shell (body_shell.stl, ~19.4 g, 0.8 mm wall) stays inside the chassis
    outline, rests on the chassis end walls and the platform, held by four
    6x2 magnets over the platform magnets. Side skirts follow the motor
    frame slope 1 mm below its edge; gaps around the platform legs. Roof has
    stencil EDOG lettering and tapered "spine" slots.
    Visor (xiao_visor.stl, ~3.6 g) is glued on top of the shell over the
    XIAO opening: camera window matches the stand cutout, two 3 mm slots
    for the flat antenna.
    [EDOG_V_XIAO_Layout.FCStd, body_shell.stl, xiao_visor.stl]
2026-10-25 Vision calibration: camera height per stance, calibratable FOV; patrol button in app
    - floor points remember body height; camera height follows the active
    stance (base 70 mm / stopper 78 mm), camera is rigid on the body
    - measured camera height: points fit tilt and horizontal FOV
    - floor points above frame center are accepted (camera tilts only ~6 deg)
    - portal: frame center crosshair for placing calibration objects,
    measured-height field, floor line uses per-frame camera geometry
    - greeting is joy only; 3D model moved under the camera row
    - Android: start/stop patrol button over the video
2026-10-25 Power-on base stance, patrol only by button, stance toggle in app, OTA keeps state
    - On power-on the dog stands in the base stance; patrol never starts by itself
    (autostart setting and countdown removed).
    - Manual control (stick, gamepad button, portal motion command) switches patrol
    off instead of pausing it; it is turned on again only by a button.
    - Android app: button to toggle base / base-on-stoppers stance.
    - OTA: the board remembers servos, stance and patrol in RTC memory before
    writing and restores them after the update reboot; ota.py no longer turns
    servos off beforehand.
    - Ignore xiao/backup/ (saved firmware images).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
    [api.cpp, api.h, config.h]
2026-10-25 Android: gap between patrol and stance buttons, equal width
2026-10-25 XIAO: describe camera in /api/config on every request
    The API starts before the camera, so a request right after boot cached
    an empty sensor and the Android app reported no camera.
2026-10-25 XIAO: faster gait — servo limit 750°/s, base 2.9 Hz, stopper 2.2 Hz; trot starts with FR+RL
    UBEC gives 6 V, so the servo speed cap rises from 300 to 750°/s (MG90S at 6 V);
    both gaits now fit under it with ~10% margin. Starting the trot with the FR+RL
    pair walks forward better.
2026-10-25 Sleep mode: button in portal and app, auto-sleep after a minute idle
    Servos off, patrol stopped, camera sensor in standby, Wi-Fi modem sleep,
    CPU at 80 MHz; Wi-Fi and BLE stay up. Woken from portal/app, by enabling
    servos, starting patrol or any gamepad button; the dog then stands up.
2026-10-25 Patrol: covered-frame stop, visited-cell exploration, short walking exposure
    From recording 20261025-193115:
    - frames with almost no brightness spread (lens against a wall) count as
    covered: closeness 1, free 0, floor model does not learn from them
    (they used to read as "floor to the horizon" and the dog kept walking)
    - dead-reckoned position and 0.5 m visited cells; scan prefers unvisited
    directions, away from the visited area, slightly the current heading
    - approach: person may be lost for 4 s; give up after 20 s and ignore
    people for a while instead of spinning in place
    - camera: manual short exposure while walking (default 120 sensor lines),
    gain adapts to frame brightness up t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
    [config.h, patrol.cpp, vision.cpp]
2026-10-25 cad update
    [EDOG_V_XIAO_Layout.FCStd]
2026-10-26 README for builders: BOM, print list, wiring, assembly; full assembly with legs and renders; remove old CAD versions
    [EDOG_F_Cylinder_OutboardServos.FCStd, EDOG_G_ExternalServoSeats.FCStd, EDOG_H_RoundedBody_200mm.FCStd, EDOG_I_RoundedBody_Working.FCStd, EDOG_J_InternalElectronics_Working.FCStd, EDOG_K_WidenedEnds.FCStd, EDOG_L_Stacked_DCDC.FCStd, EDOG_M_Captive_M3_Nuts.FCStd]
